fezboy/ece129_discharger/hardware/ece129_discharger.pdf

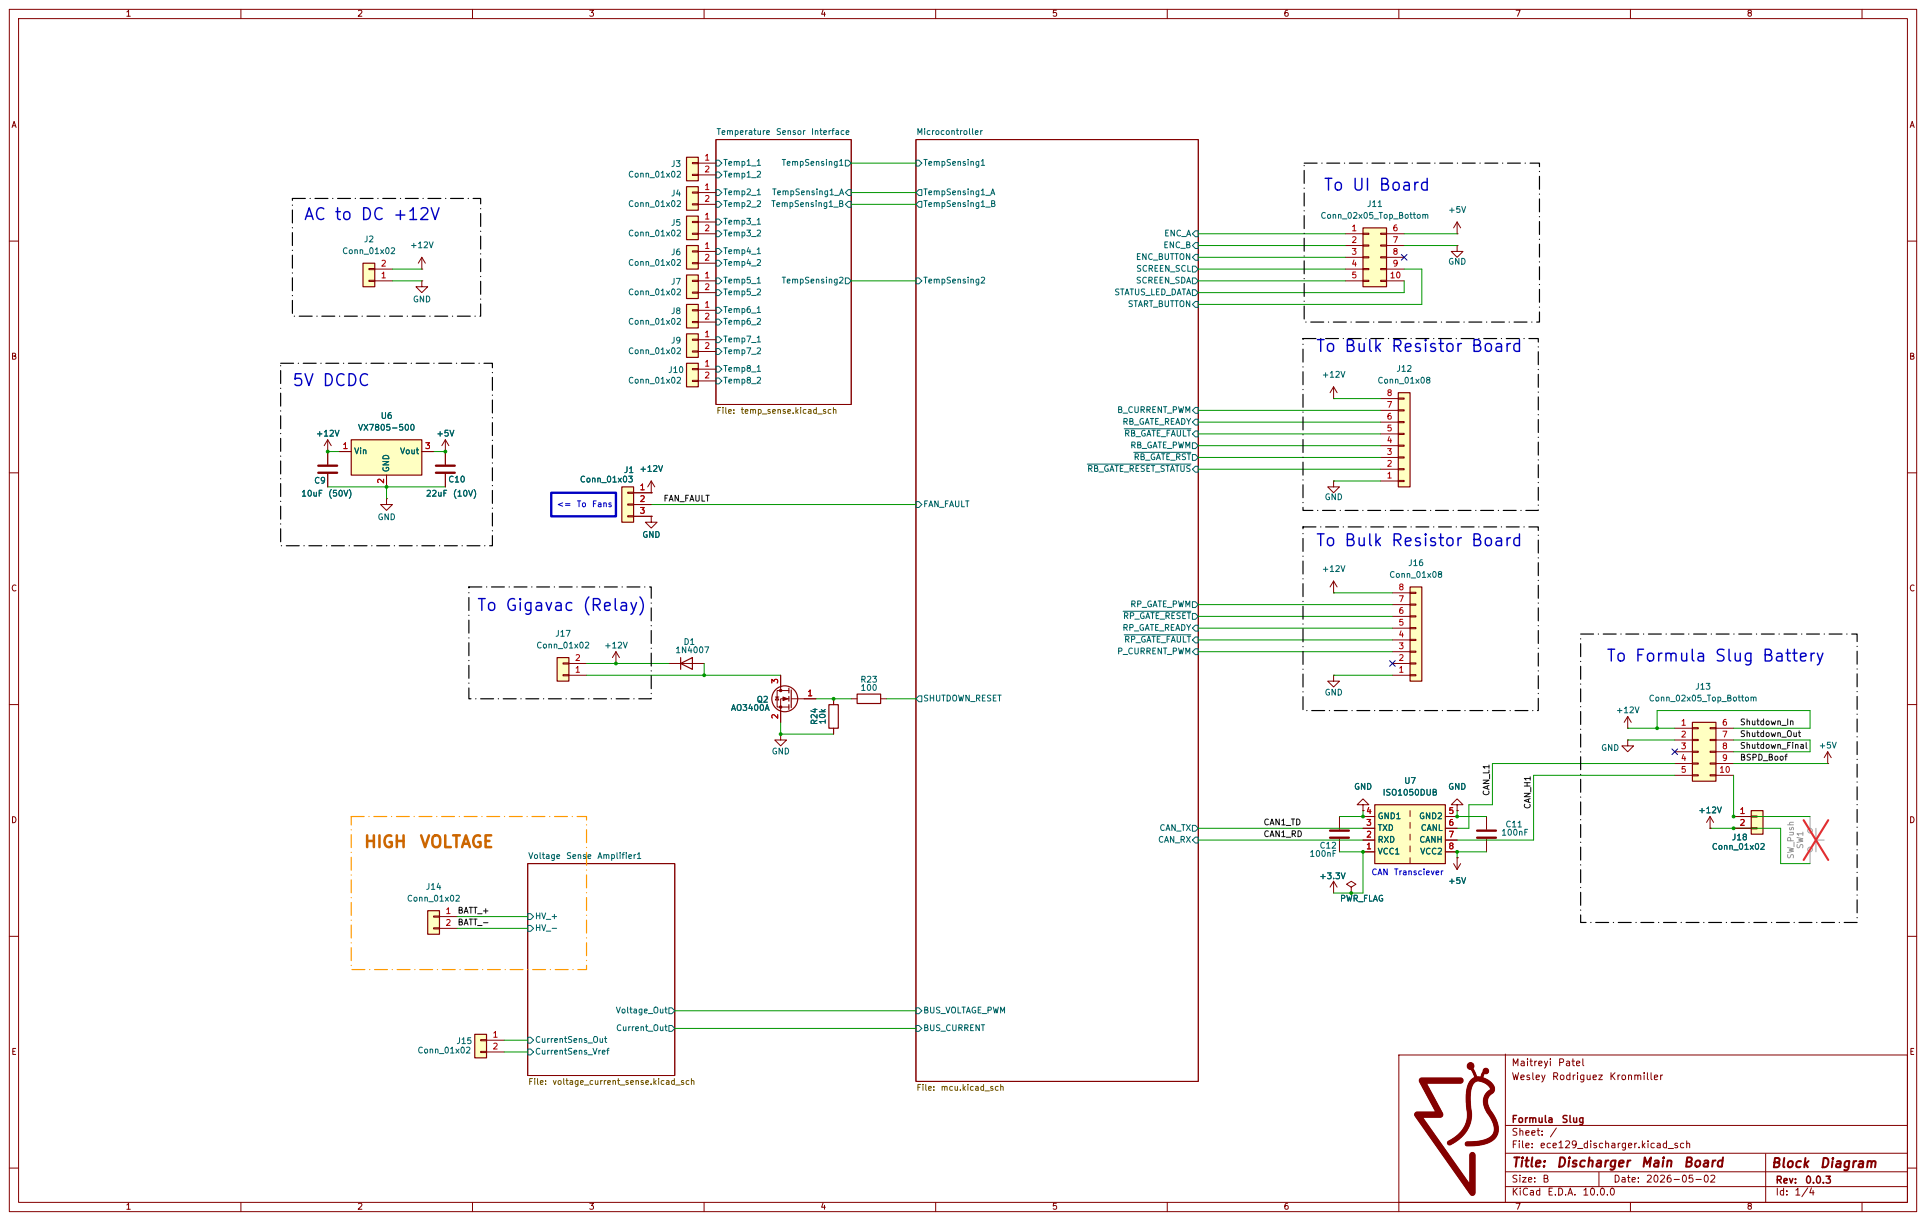
[picture p1: page 1]

To Bulk Resistor Board

CAN_RX CAN_TX P_CURRENT_PWM

6 | J16 Conn_01x08 GND

2 1

To Formula Slug Battery

Title: Discharger Main Board
Size: B | Rev: 0.0.3

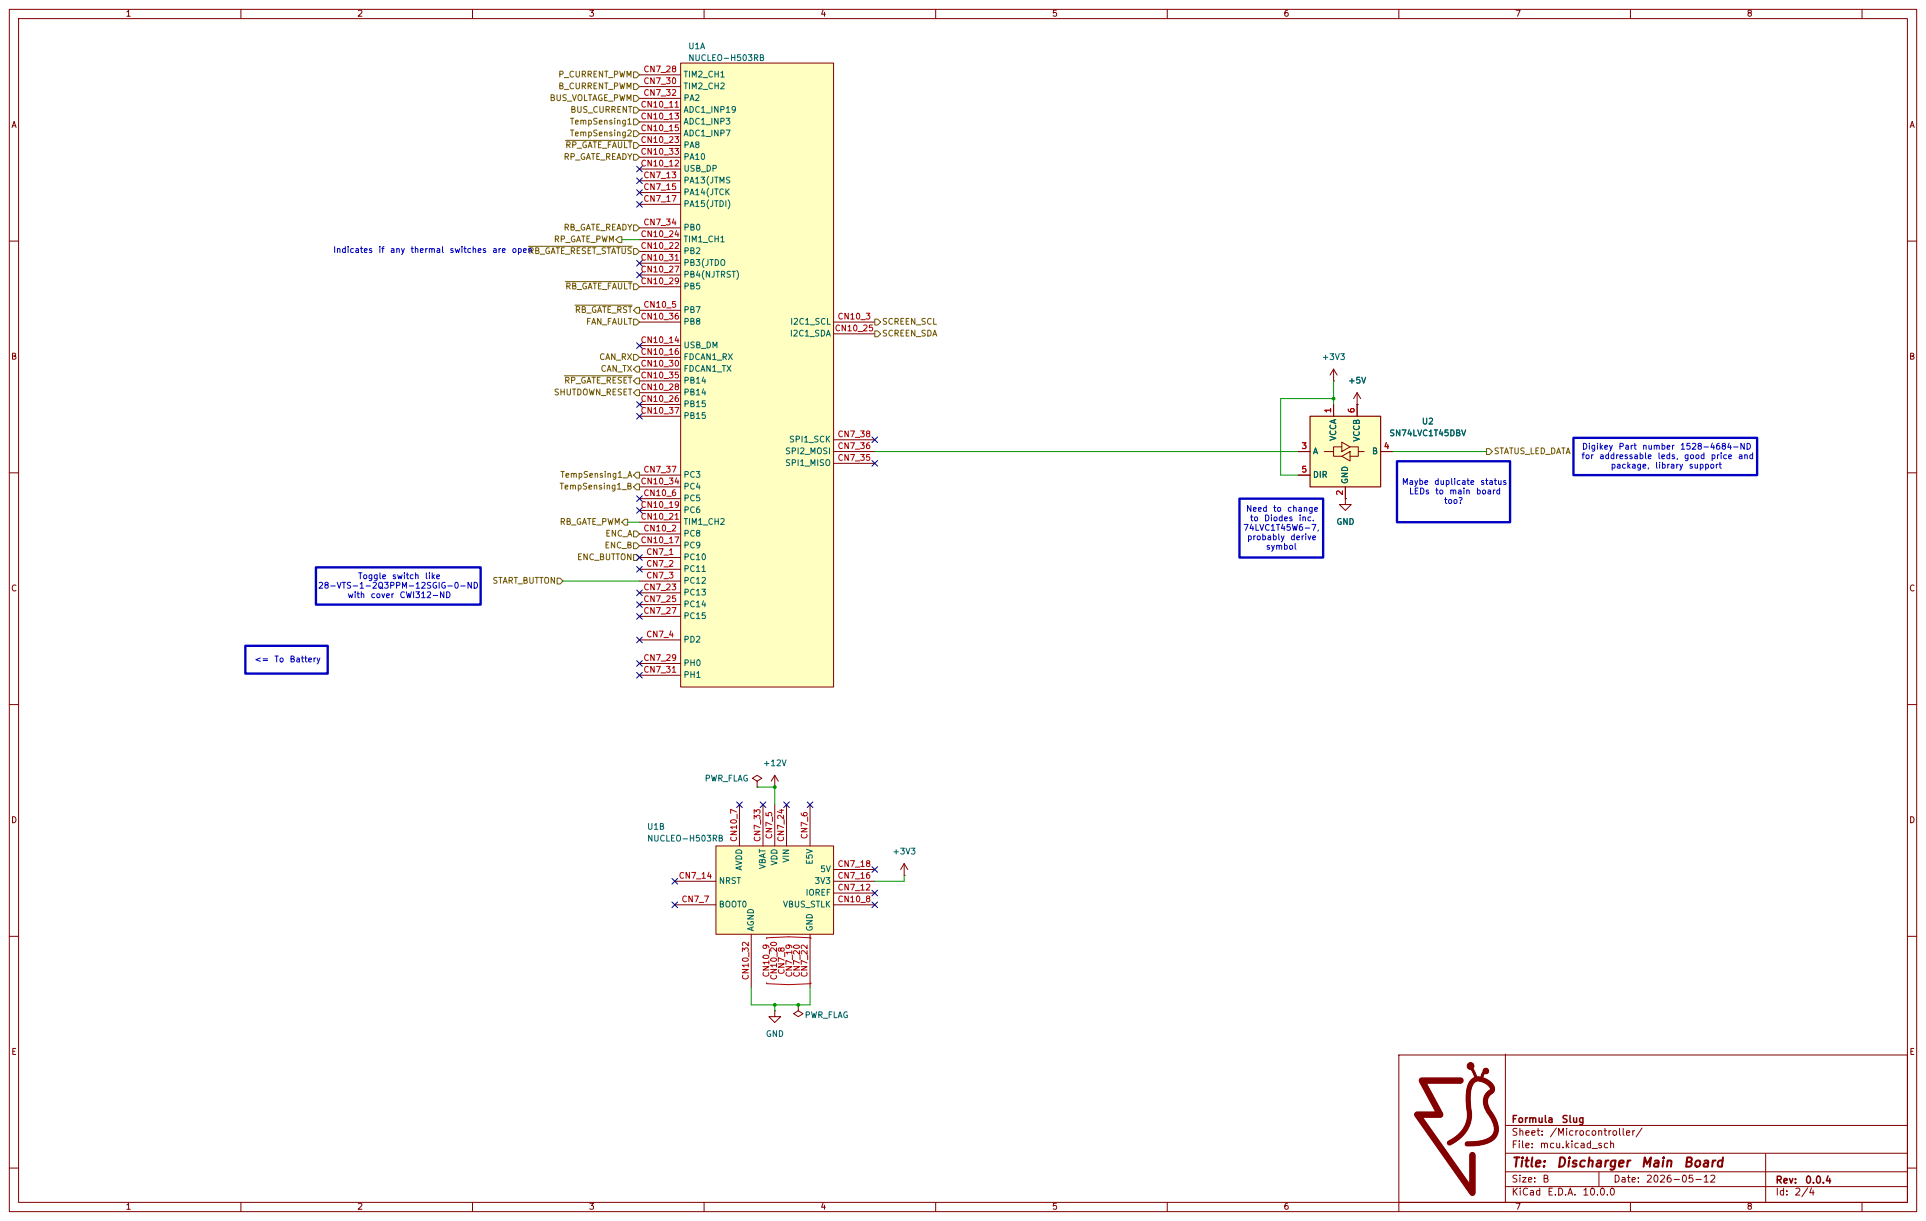
[picture p2: page 2]

for addressable leds, good price and

Maybe duplicate status
LEDs to main board

too? Need to change

to Diodes inc. 74LVC1T45W6-7, probably derive

Toggle switch like 28-VTS-1-2Q3PPM-12SGIG-0-ND with cover CWI312-ND <= To Battery

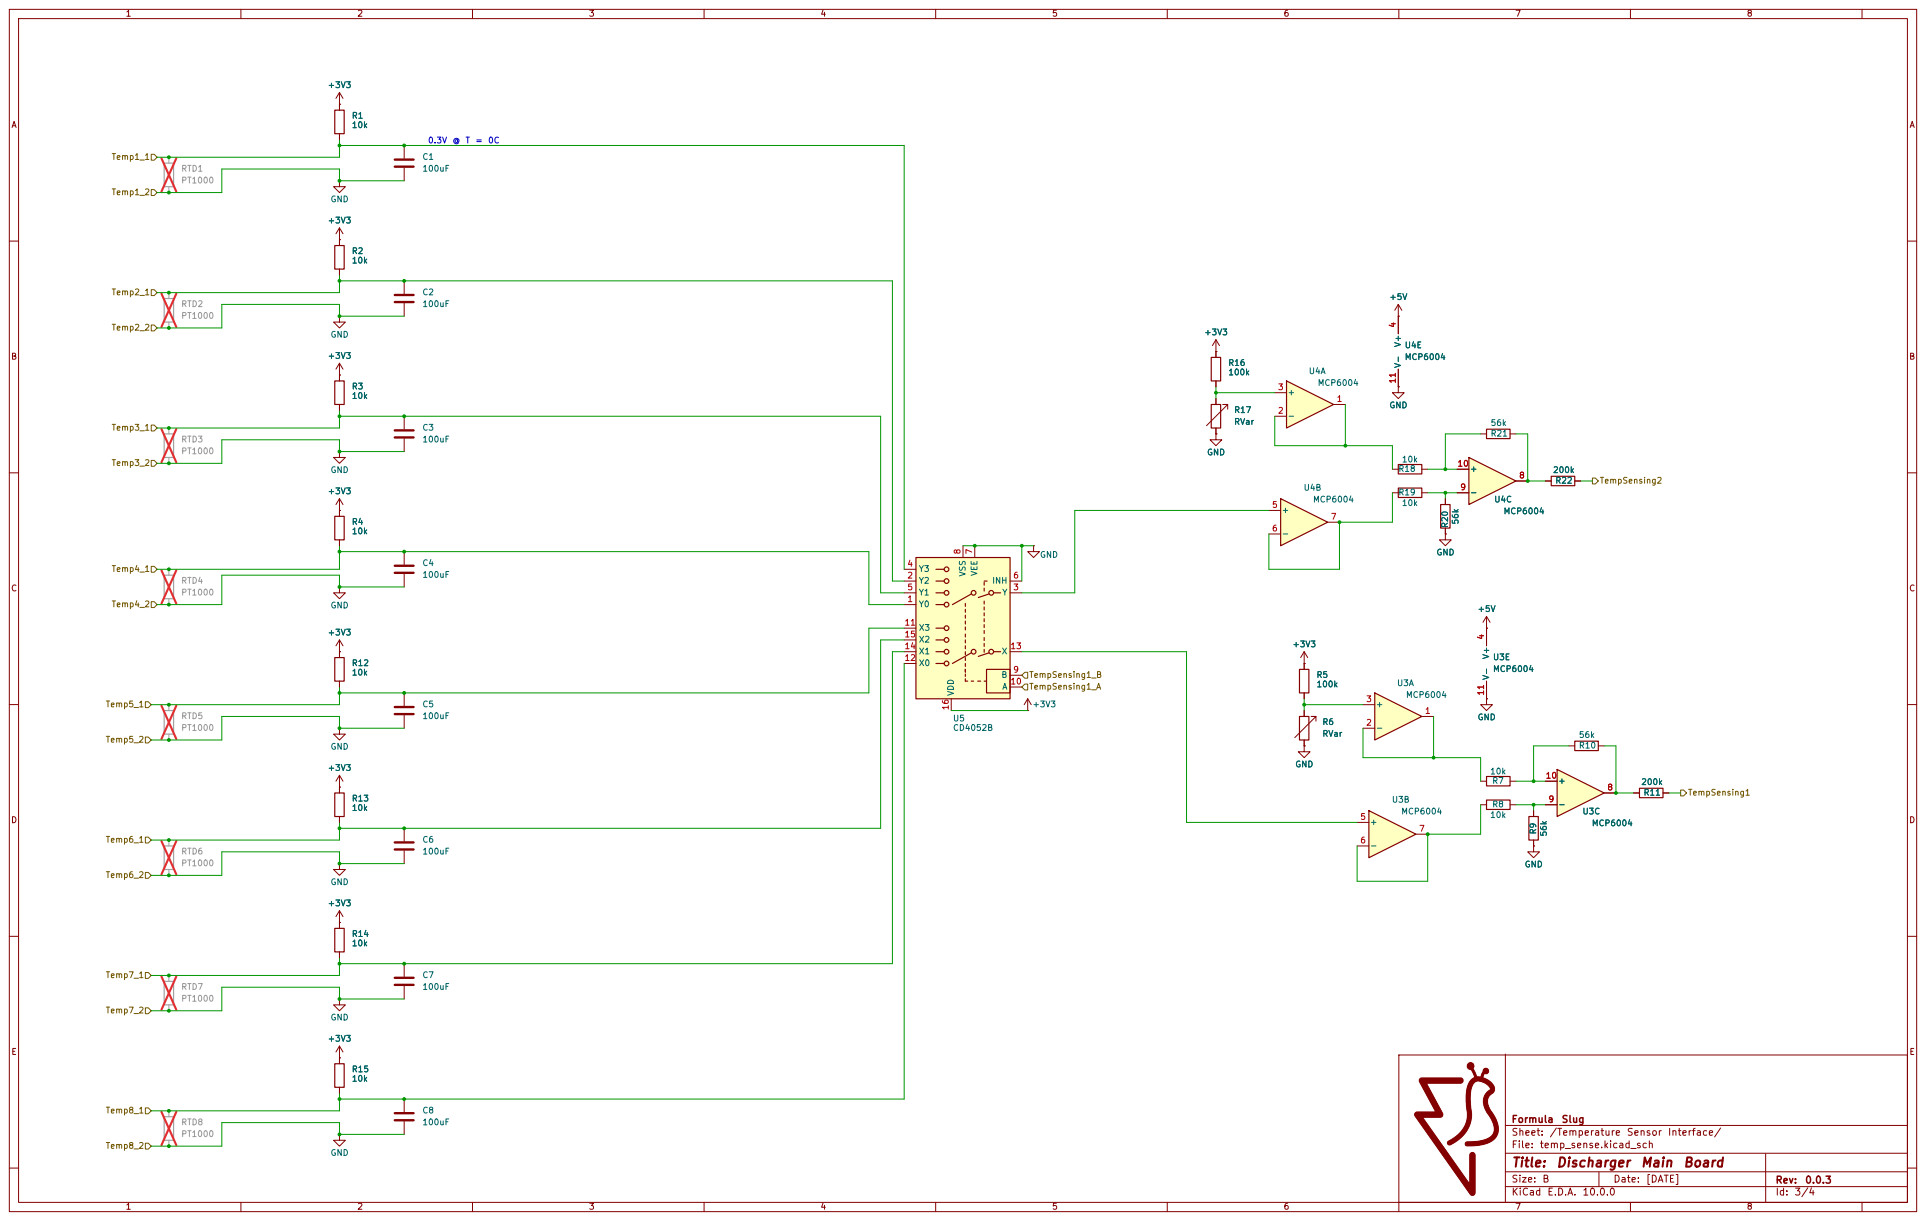
[picture p3: page 3]

Formula Slug
Sheet: /Temperature Sensor Interface/
File: temp_sense.kicad_sch

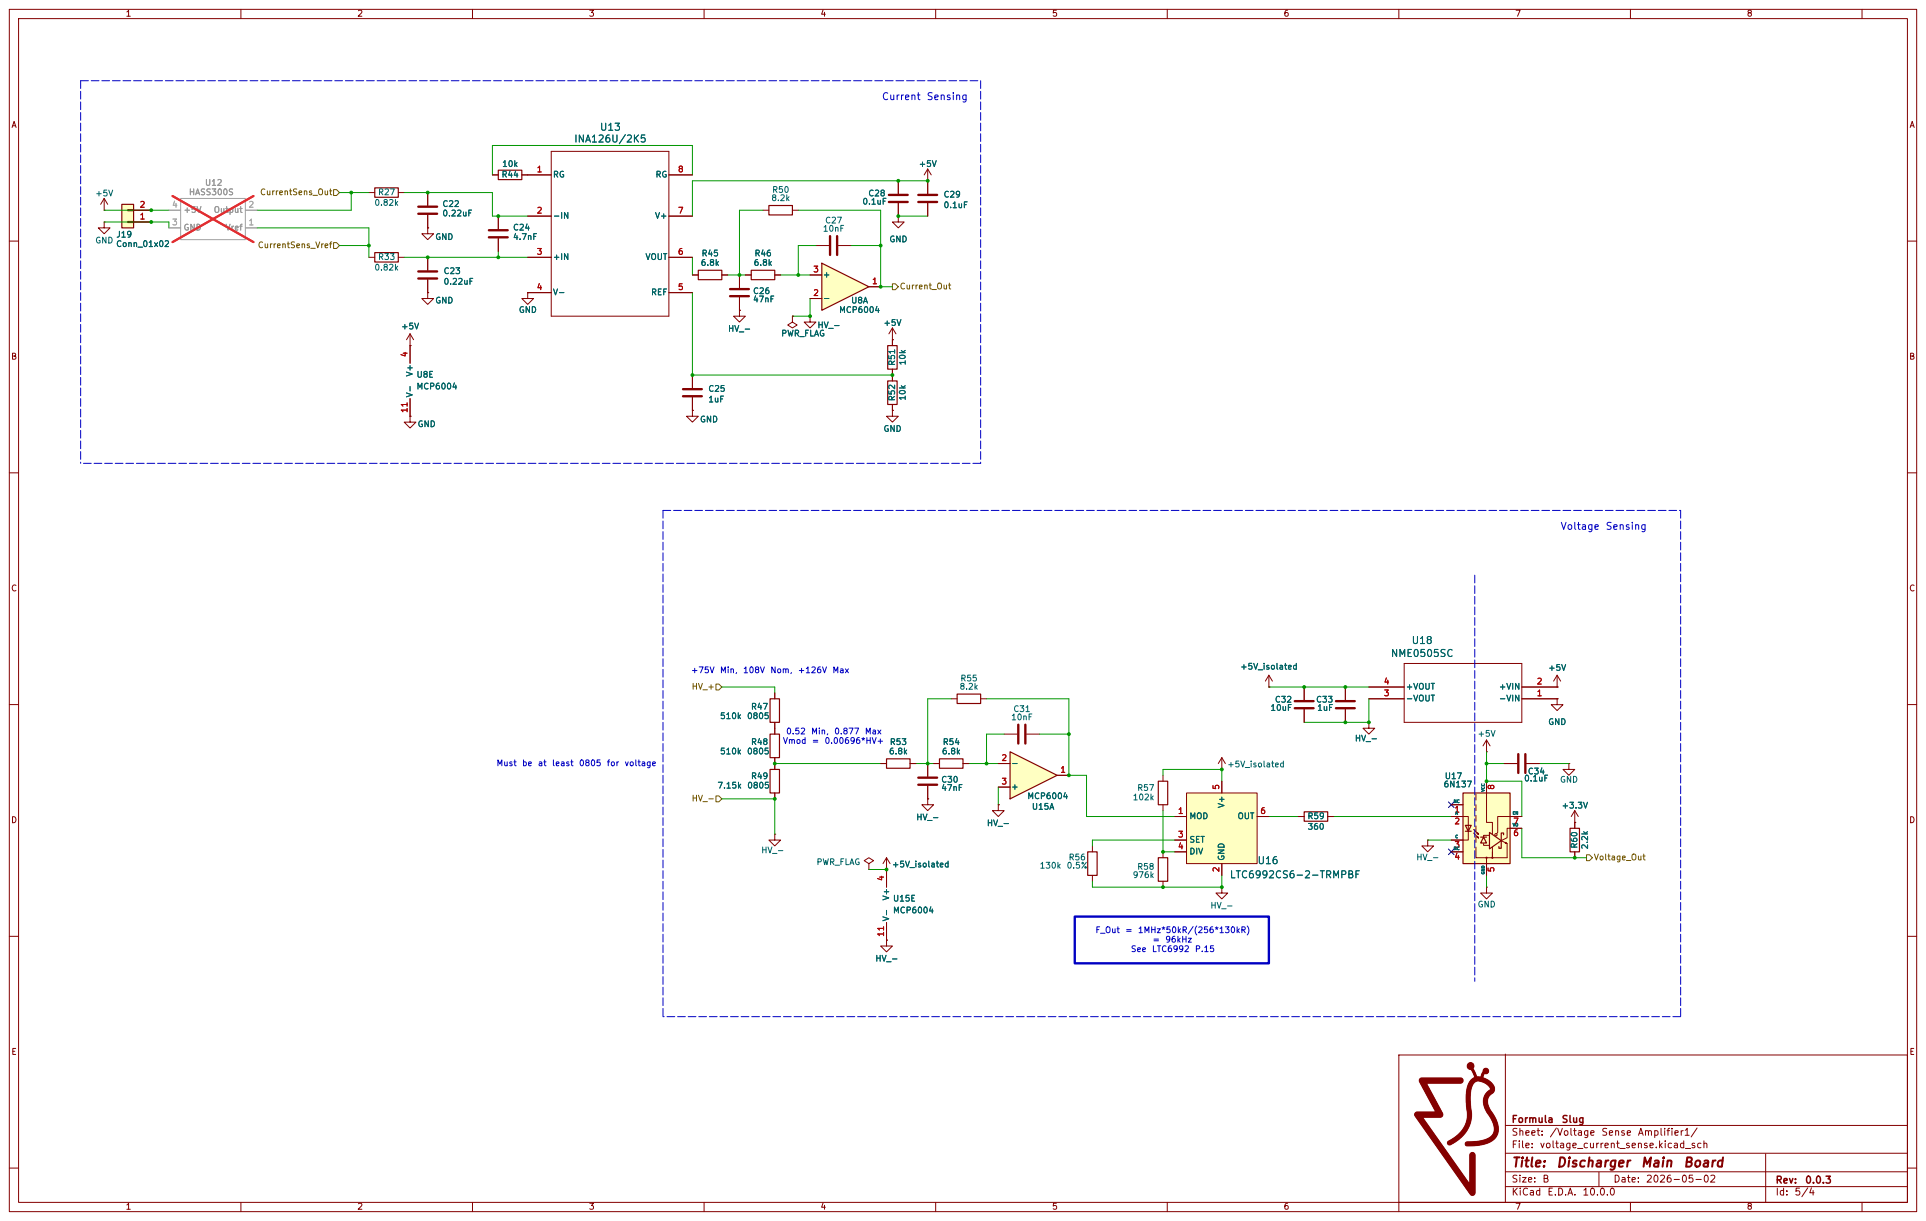
[picture p4: page 4]

5 OUT 6 +5V_isolated U18 NME0505SC -VIN 1 +VIN 2 -VOUT 3 +VOUT 4

0.52 Min, 0.877 Max Vmod = 0.00696*HV+

Must be at least 0805 for voltage
