fezboy/ece129_discharger/hardware/ece129_discharger.kicad_pcb

## KiCad design hardware/ece129_discharger.kicad_pcb (2026-05-23)

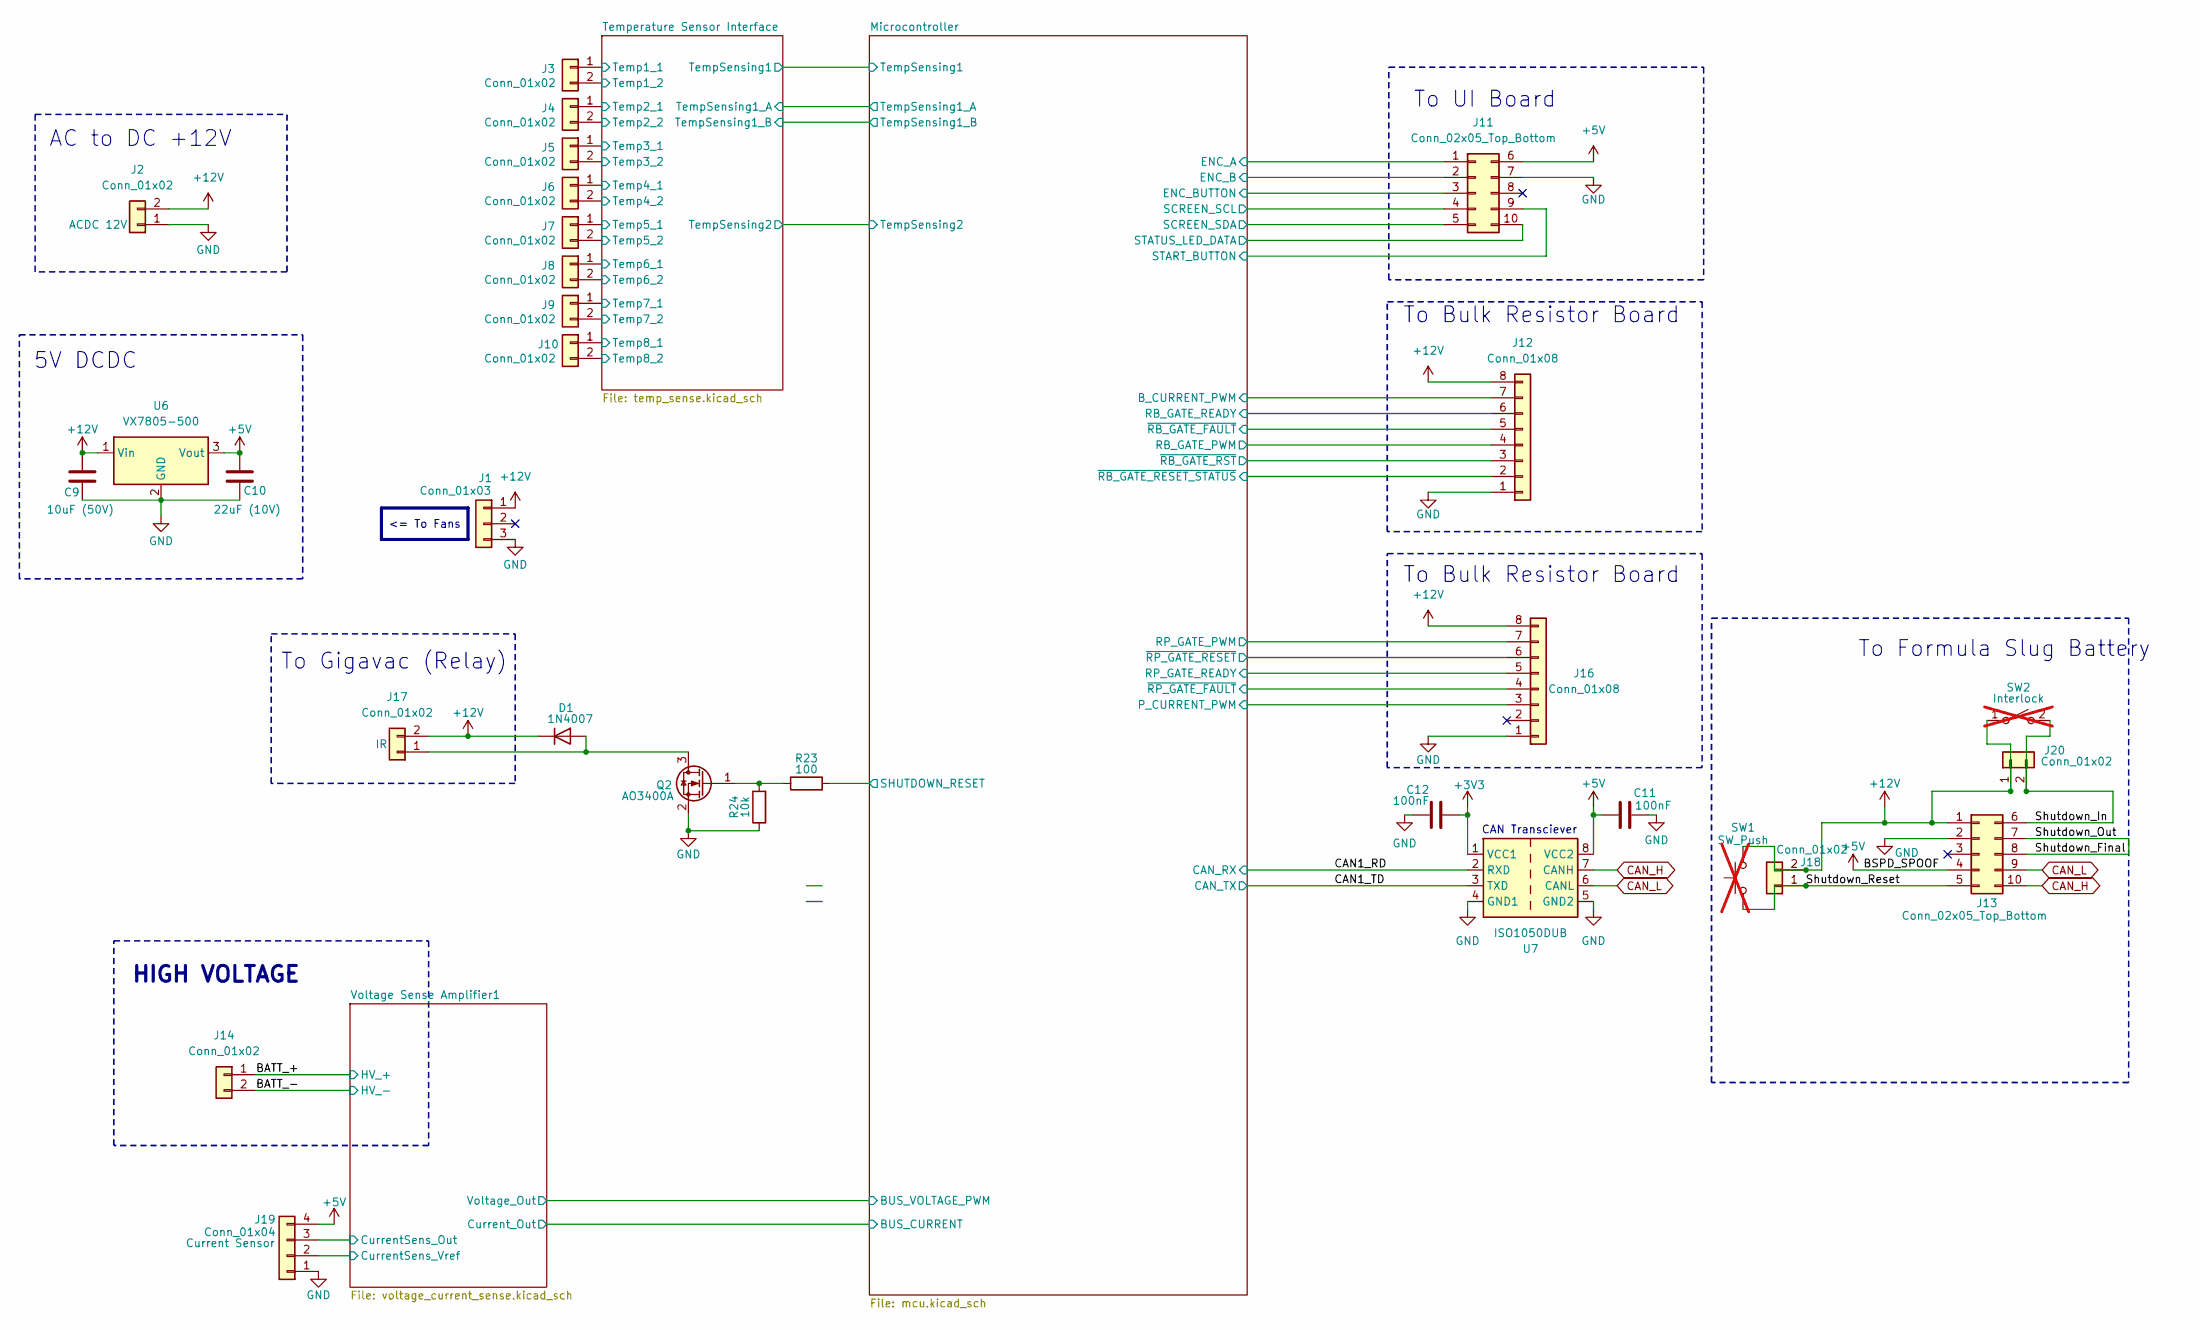
[picture p5: schematic ece129_discharger.kicad_sch, Discharger Main Board]

Parts:
C9: 10uF (50V); C_0805_2012Metric_Pad1.18x1.45mm_HandSolder
C10: 22uF (10V); C_0805_2012Metric_Pad1.18x1.45mm_HandSolder
C11, C12: 100nF; C_0805_2012Metric_Pad1.18x1.45mm_HandSolder
D1: 1N4007; D_DO-41_SOD81_P10.16mm_Horizontal
J1: Conn_01x03; Molex_Nano-Fit_105309-xx03_1x03_P2.50mm_Vertical
J2, J3, J4, J5, J6, J7, J8, J9, J10, J14, J17, J18, J20: Conn_01x02; Molex_Nano-Fit_105309-xx02_1x02_P2.50mm_Vertical
J11, J13: Conn_02x05_Top_Bottom; Molex_Nano-Fit_105310-xx10_2x05_P2.50mm_Vertical
J12, J16: Conn_01x08; Molex_Nano-Fit_105309-xx08_1x08_P2.50mm_Vertical
J19: Conn_01x04; Molex_Nano-Fit_105309-xx04_1x04_P2.50mm_Vertical
Q2: AO3400A; SOT-23
R23: 100; R_0805_2012Metric_Pad1.20x1.40mm_HandSolder
R24: 10k; R_0805_2012Metric_Pad1.20x1.40mm_HandSolder
SW1: SW_Push; not fitted
SW2: Interlock; not fitted
U6: VX7805-500; Converter_DCDC_TRACO_TSR0.5-24xx_TSR0.5-24xxx_THT
U7: ISO1050DUB; SOP-8_6.62x9.15mm_P2.54mm

Connections:
+3V3: C12.2, U7.1 (VCC1); also elsewhere on the board
+5V: C10.1, C11.2, J11.6, J13.4, J19.4, U6.3 (Vout), U7.8 (VCC2); also elsewhere on the board
+12V: C9.1, D1.1 (K), J1.1, J2.2, J12.8, J13.1, J16.8, J17.2, J18.2, J20.1, SW1.1, SW2.1 (A), U6.1 (Vin); also elsewhere on the board
/BATT_+: J14.1; also elsewhere on the board
/CAN1_RD: U7.2 (RXD); also elsewhere on the board
/CAN1_TD: U7.3 (TXD); also elsewhere on the board
/Microcontroller/B_CURRENT_PWM: J12.7; also elsewhere on the board
/Microcontroller/ENC_A: J11.1; also elsewhere on the board
/Microcontroller/ENC_B: J11.2; also elsewhere on the board
/Microcontroller/ENC_BUTTON: J11.3; also elsewhere on the board
/Microcontroller/P_CURRENT_PWM: J16.3; also elsewhere on the board
/Microcontroller/RB_GATE_PWM: J12.4; also elsewhere on the board
/Microcontroller/RB_GATE_READY: J12.6; also elsewhere on the board
/Microcontroller/RP_GATE_PWM: J16.7; also elsewhere on the board
/Microcontroller/RP_GATE_READY: J16.5; also elsewhere on the board
/Microcontroller/SCREEN_SCL: J11.4; also elsewhere on the board
/Microcontroller/SCREEN_SDA: J11.5; also elsewhere on the board
/Microcontroller/SHUTDOWN_RESET: R23.2; also elsewhere on the board
/Microcontroller/START_BUTTON: J11.9; also elsewhere on the board
/Microcontroller/STATUS_LED_DATA: J11.10; also elsewhere on the board
/Microcontroller/~RB_GATE_FAULT: J12.5; also elsewhere on the board
/Microcontroller/~RB_GATE_RESET_STATUS: J12.2; also elsewhere on the board
/Microcontroller/~RB_GATE_RST: J12.3; also elsewhere on the board
/Microcontroller/~RP_GATE_FAULT: J16.4; also elsewhere on the board
/Microcontroller/~RP_GATE_RESET: J16.6; also elsewhere on the board
/Shutdown_Final: J13.7, J13.8
/Shutdown_In: J13.6, J20.2, SW2.2 (B)
/Shutdown_Reset: J13.5, J18.1, SW1.2
/Temperature Sensor Interface/Temp1_1: J3.1; also elsewhere on the board
/Temperature Sensor Interface/Temp2_1: J4.1; also elsewhere on the board
/Temperature Sensor Interface/Temp3_1: J5.1; also elsewhere on the board
/Temperature Sensor Interface/Temp4_1: J6.1; also elsewhere on the board
/Temperature Sensor Interface/Temp5_1: J7.1; also elsewhere on the board
/Temperature Sensor Interface/Temp6_1: J8.1; also elsewhere on the board
/Temperature Sensor Interface/Temp7_1: J9.1; also elsewhere on the board
/Temperature Sensor Interface/Temp8_1: J10.1; also elsewhere on the board
/Voltage Sense Amplifier1/CurrentSens_Out: J19.3; also elsewhere on the board
/Voltage Sense Amplifier1/CurrentSens_Vref: J19.2; also elsewhere on the board
CAN_H: J13.10, U7.7 (CANH)
CAN_L: J13.9, U7.6 (CANL)
GND: C9.2, C10.2, C11.1, C12.1, J1.3, J2.1, J3.2, J4.2, J5.2, J6.2, J7.2, J8.2, J9.2, J10.2, J11.7, J12.1, J13.2, J16.1, J19.1, Q2.2 (S), R24.1, U6.2 (GND), U7.4 (GND1), U7.5 (GND2); also elsewhere on the board
HV_-: J14.2; also elsewhere on the board
unnamed: D1.2 (A), J17.1, Q2.3 (D)
unnamed: Q2.1 (G), R23.1, R24.2

Notes on the sheet:
CAN Transciever
AC to DC +12V
5V DCDC
To Bulk Resistor Board
HIGH VOLTAGE
To UI Board
To Formula Slug Battery
To Gigavac (Relay)
<= To Fans

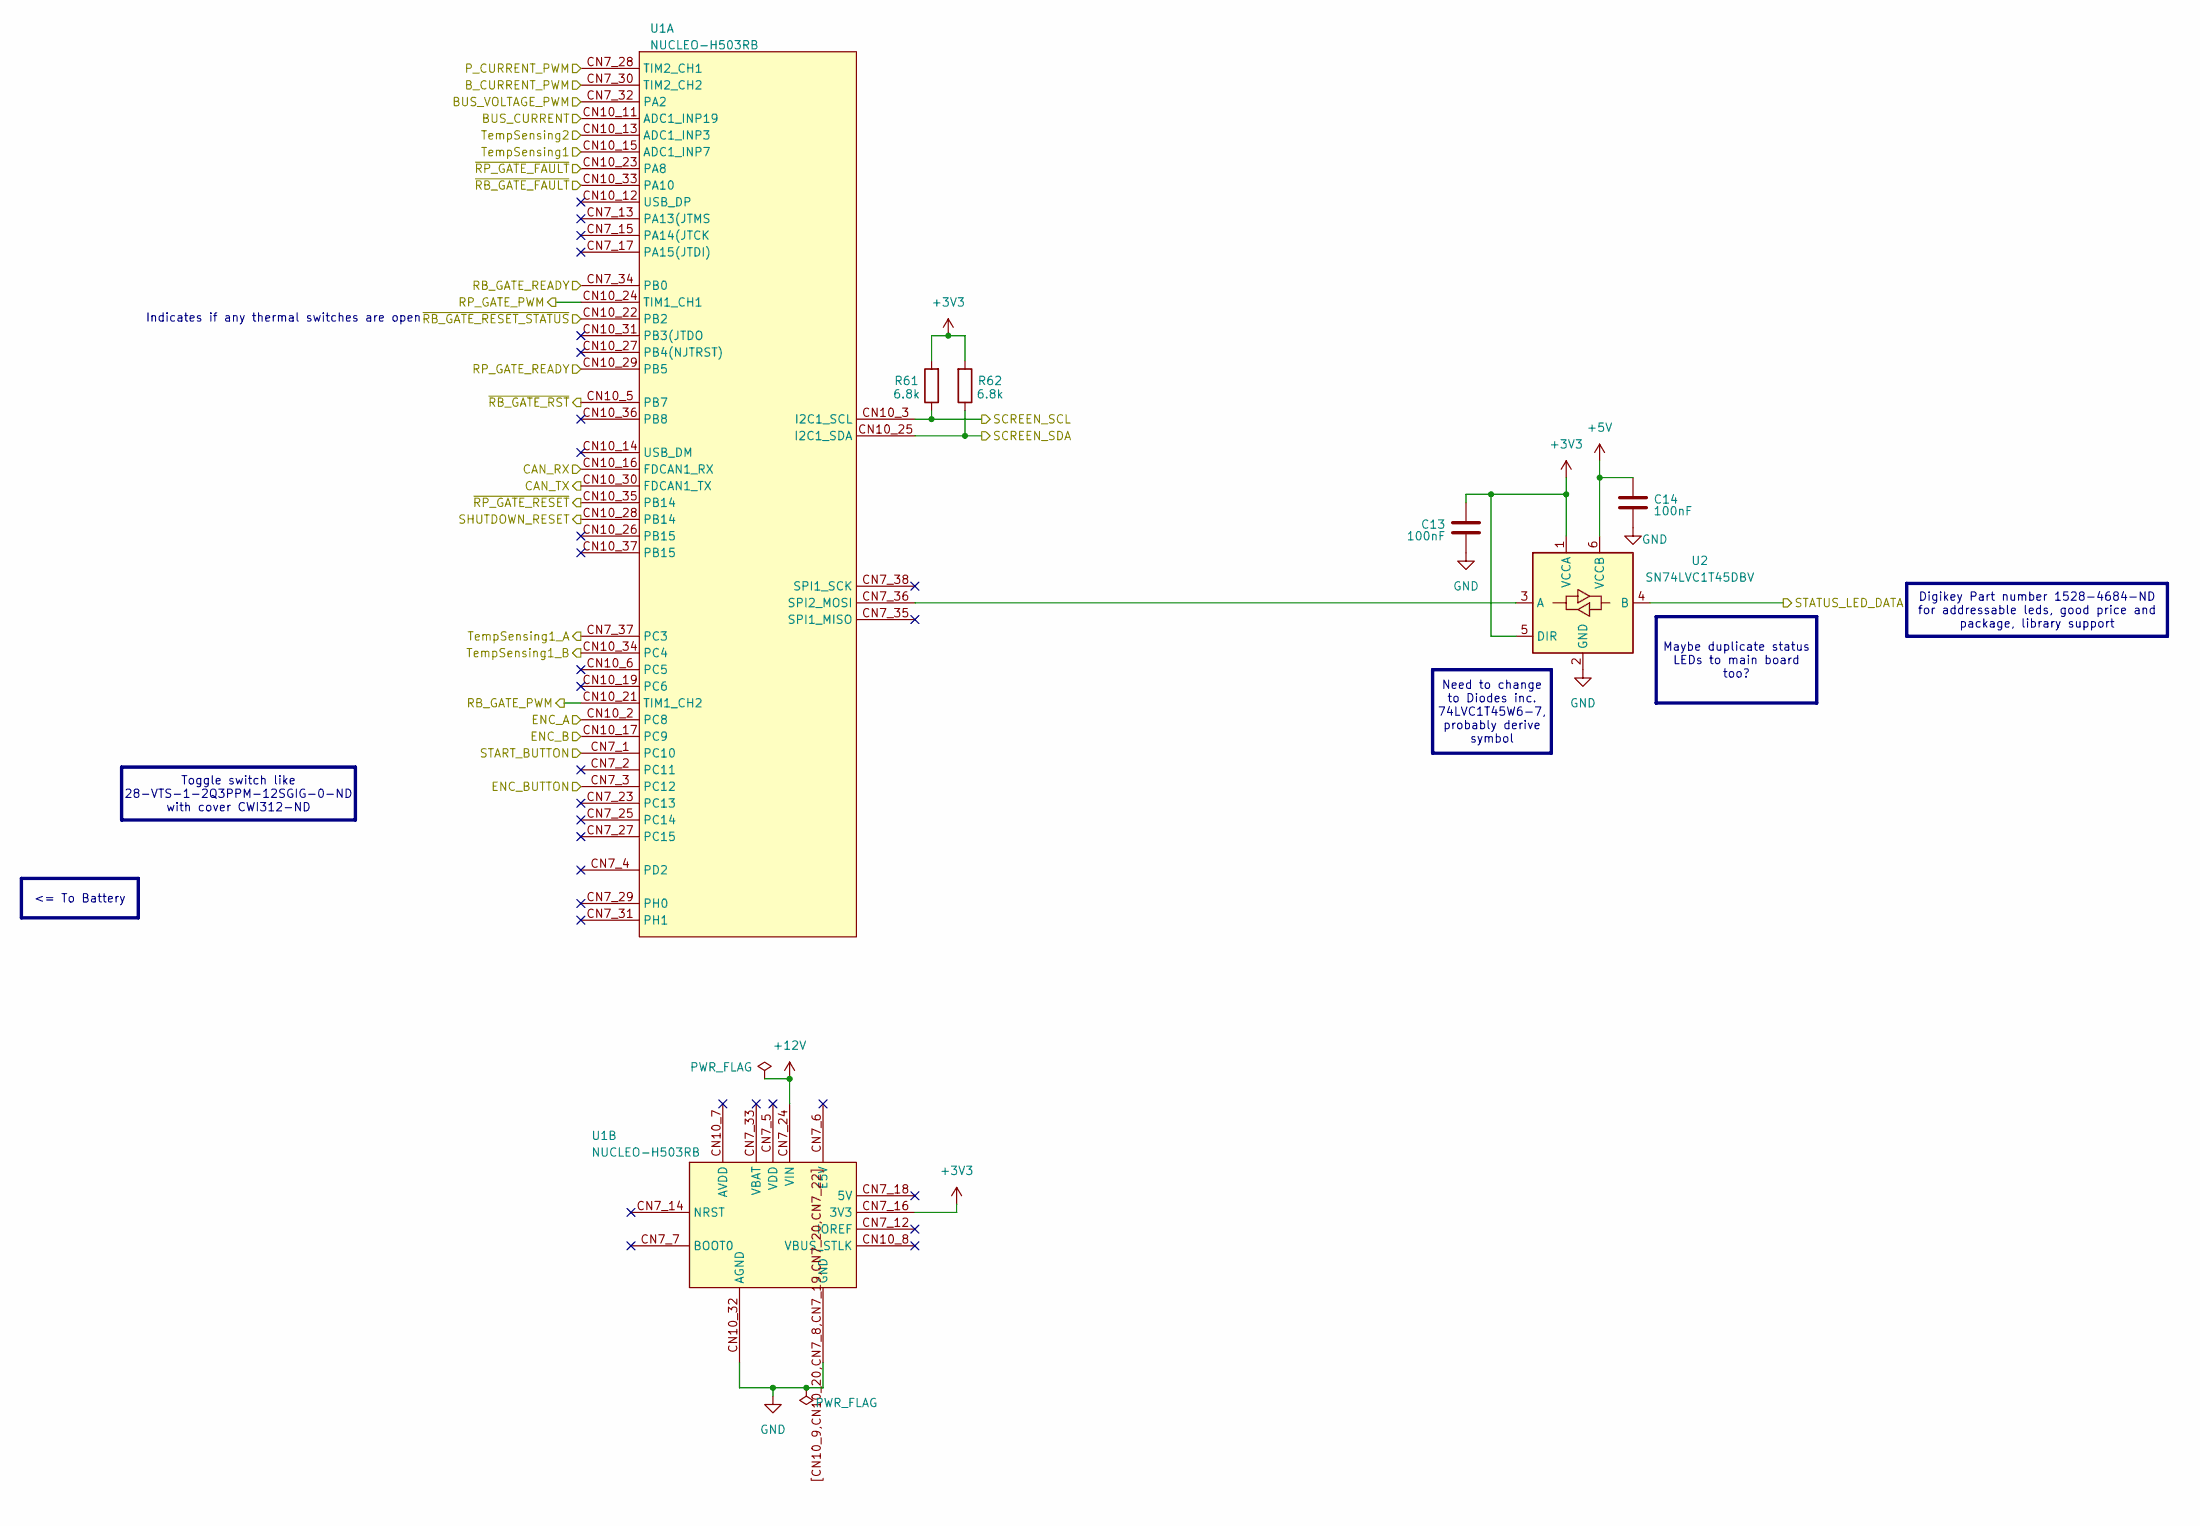
[picture p6: schematic mcu.kicad_sch, Discharger Main Board]

Parts:
C13, C14: 100nF; C_0805_2012Metric_Pad1.18x1.45mm_HandSolder
R61, R62: 6.8k; R_0805_2012Metric_Pad1.20x1.40mm_HandSolder
U1: NUCLEO-H503RB
U2: SN74LVC1T45DBV; SOT-23-6

Connections:
+3V3: C13.1, R61.2, R62.2, U1.CN7_16 (3V3), U2.1 (VCCA), U2.5 (DIR); also elsewhere on the board
+5V: C14.1, U2.6 (VCCB); also elsewhere on the board
+12V: U1.CN7_24 (VIN); also elsewhere on the board
/CAN1_RD: U1.CN10_16 (FDCAN1_RX); also elsewhere on the board
/CAN1_TD: U1.CN10_30 (FDCAN1_TX); also elsewhere on the board
/Microcontroller/BUS_CURRENT: U1.CN10_11 (ADC1_INP19); also elsewhere on the board
/Microcontroller/BUS_VOLTAGE_PWM: U1.CN7_32 (PA2); also elsewhere on the board
/Microcontroller/B_CURRENT_PWM: U1.CN7_30 (TIM2_CH2); also elsewhere on the board
/Microcontroller/ENC_A: U1.CN10_2 (PC8); also elsewhere on the board
/Microcontroller/ENC_B: U1.CN10_17 (PC9); also elsewhere on the board
/Microcontroller/ENC_BUTTON: U1.CN7_3 (PC12); also elsewhere on the board
/Microcontroller/P_CURRENT_PWM: U1.CN7_28 (TIM2_CH1); also elsewhere on the board
/Microcontroller/RB_GATE_PWM: U1.CN10_21 (TIM1_CH2); also elsewhere on the board
/Microcontroller/RB_GATE_READY: U1.CN7_34 (PB0); also elsewhere on the board
/Microcontroller/RP_GATE_PWM: U1.CN10_24 (TIM1_CH1); also elsewhere on the board
/Microcontroller/RP_GATE_READY: U1.CN10_29 (PB5); also elsewhere on the board
/Microcontroller/SCREEN_SCL: R61.1, U1.CN10_3 (I2C1_SCL); also elsewhere on the board
/Microcontroller/SCREEN_SDA: R62.1, U1.CN10_25 (I2C1_SDA); also elsewhere on the board
/Microcontroller/SHUTDOWN_RESET: U1.CN10_28 (PB14); also elsewhere on the board
/Microcontroller/START_BUTTON: U1.CN7_1 (PC10); also elsewhere on the board
/Microcontroller/STATUS_LED_DATA: U2.4 (B); also elsewhere on the board
/Microcontroller/TempSensing1: U1.CN10_15 (ADC1_INP7); also elsewhere on the board
/Microcontroller/TempSensing1_A: U1.CN7_37 (PC3); also elsewhere on the board
/Microcontroller/TempSensing1_B: U1.CN10_34 (PC4); also elsewhere on the board
/Microcontroller/TempSensing2: U1.CN10_13 (ADC1_INP3); also elsewhere on the board
/Microcontroller/~RB_GATE_FAULT: U1.CN10_33 (PA10); also elsewhere on the board
/Microcontroller/~RB_GATE_RESET_STATUS: U1.CN10_22 (PB2); also elsewhere on the board
/Microcontroller/~RB_GATE_RST: U1.CN10_5 (PB7); also elsewhere on the board
/Microcontroller/~RP_GATE_FAULT: U1.CN10_23 (PA8); also elsewhere on the board
/Microcontroller/~RP_GATE_RESET: U1.CN10_35 (PB14); also elsewhere on the board
GND: C13.2, C14.2, U1.CN7_8 (GND), U1.CN7_19 (GND), U1.CN7_20 (GND), U1.CN7_22 (GND), U1.CN10_9 (GND), U1.CN10_20 (GND), U1.CN10_32 (AGND), U1.[CN10_9,CN10_20,CN7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 (GND), U2.2 (GND); also elsewhere on the board
unnamed: U1.CN7_36 (SPI2_MOSI), U2.3 (A)

Notes on the sheet:
Indicates if any thermal switches are open
Digikey Part number 1528-4684-ND for addressable leds, good price and package, library support
Toggle switch like 28-VTS-1-2Q3PPM-12SGIG-0-ND with cover CWI312-ND
Need to change to Diodes inc. 74LVC1T45W6-7, probably derive symbol
Maybe duplicate status LEDs to main board too?
<= To Battery

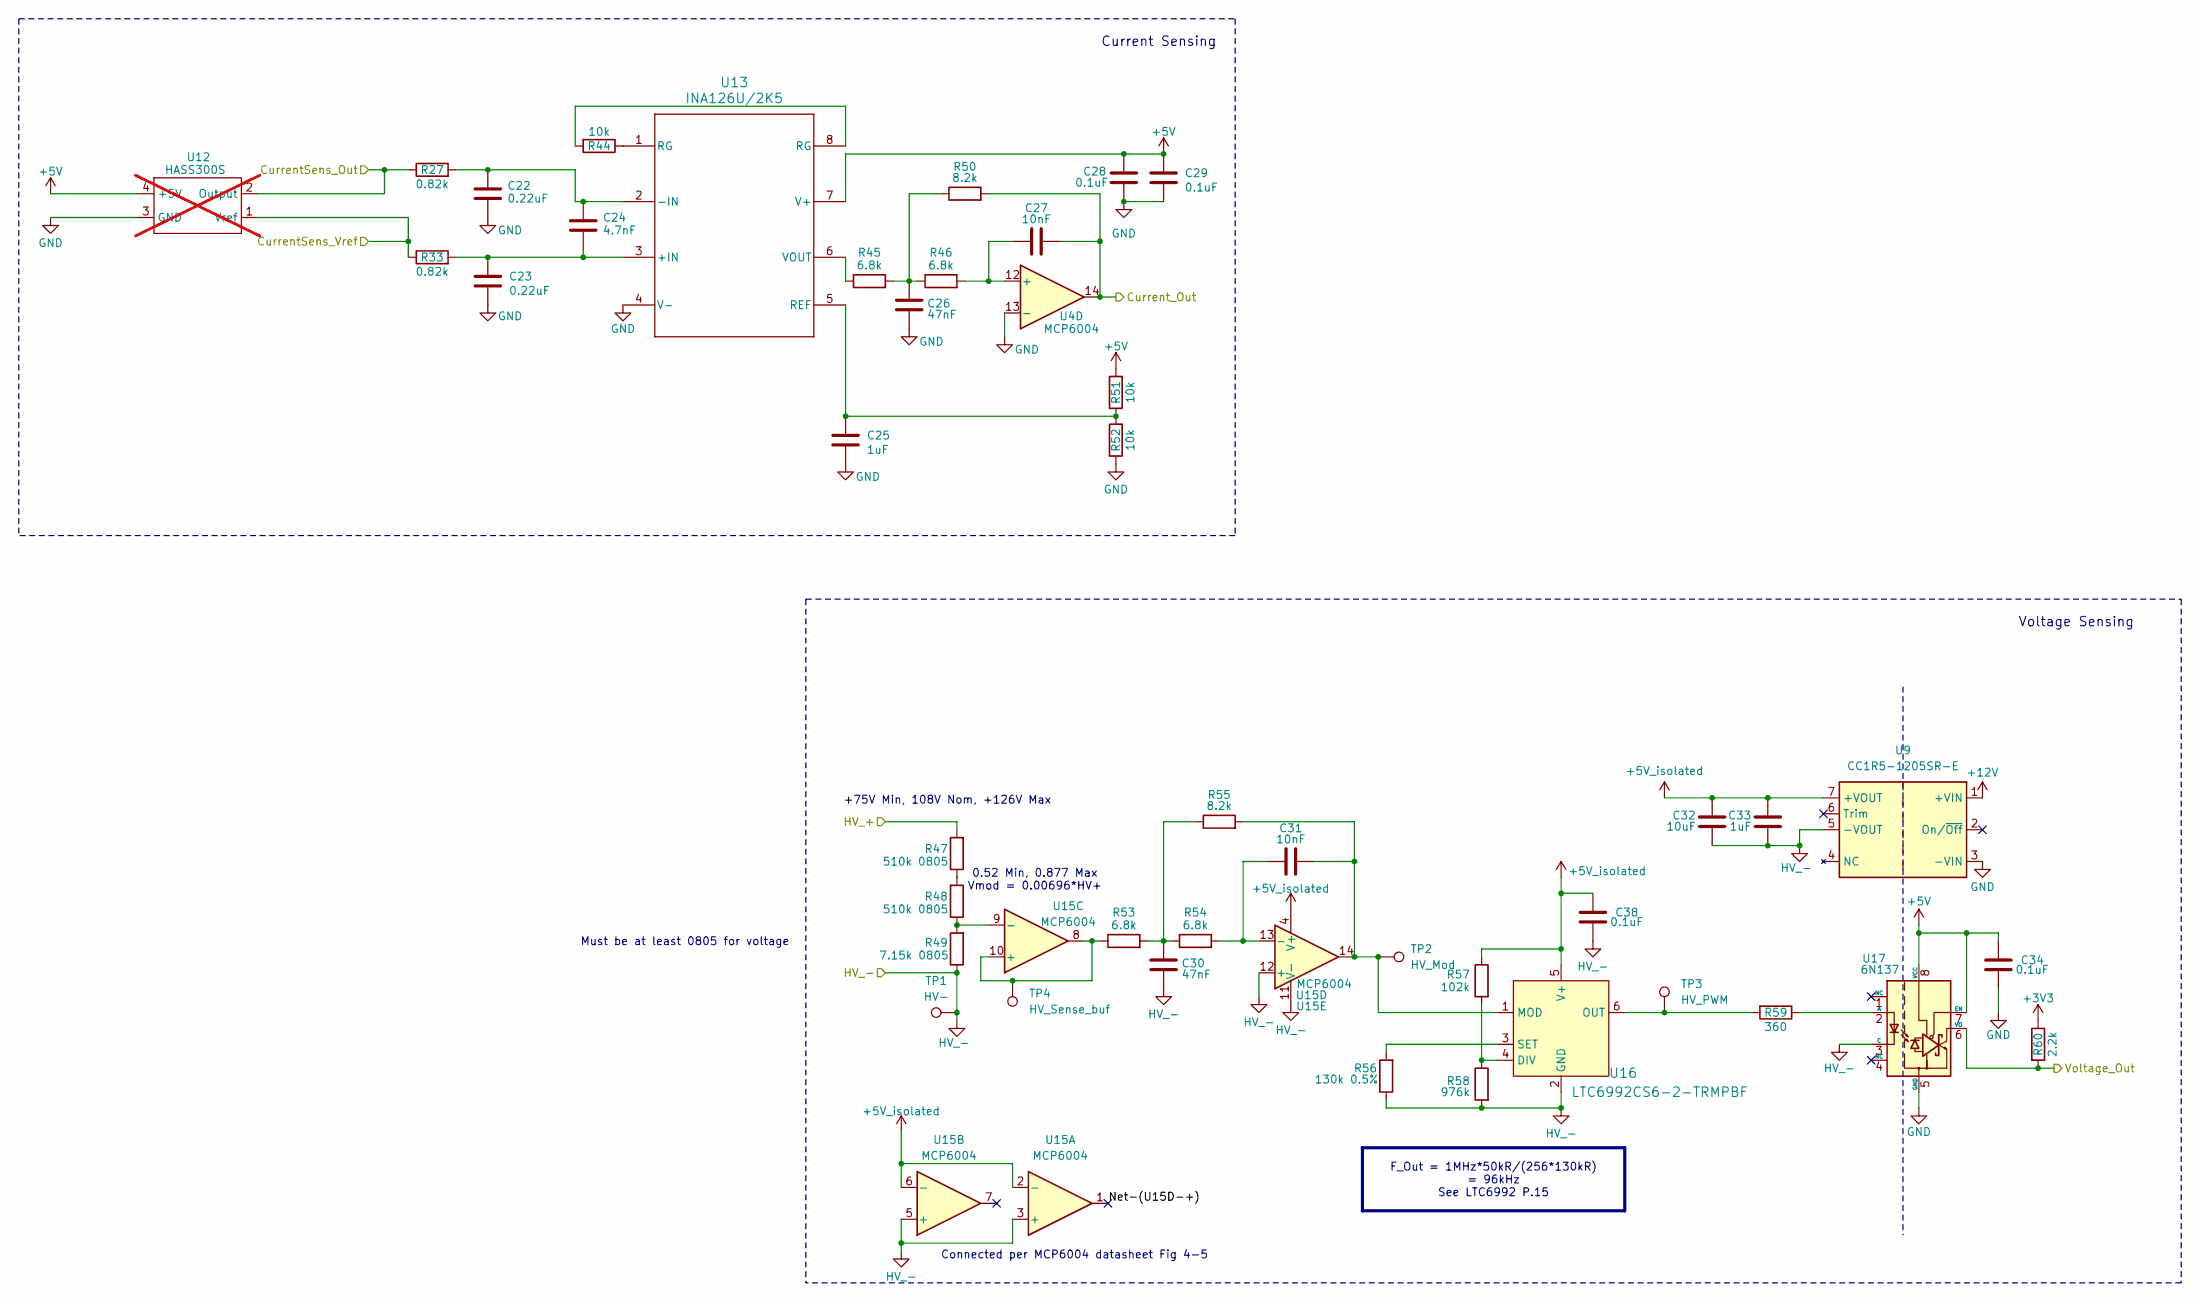
[picture p7: schematic voltage_current_sense.kicad_sch, Discharger Main Board]

Parts:
C22, C23: 0.22uF; C_0805_2012Metric_Pad1.18x1.45mm_HandSolder
C24: 4.7nF; C_0805_2012Metric_Pad1.18x1.45mm_HandSolder
C25, C33: 1uF; C_0805_2012Metric_Pad1.18x1.45mm_HandSolder
C26, C30: 47nF; C_0805_2012Metric_Pad1.18x1.45mm_HandSolder
C27, C31: 10nF; C_0805_2012Metric_Pad1.18x1.45mm_HandSolder
C28, C29, C34, C38: 0.1uF; C_0805_2012Metric_Pad1.18x1.45mm_HandSolder
C32: 10uF; C_0805_2012Metric_Pad1.18x1.45mm_HandSolder
R27, R33: 0.82k; R_0805_2012Metric_Pad1.20x1.40mm_HandSolder
R44, R51, R52: 10k; R_0805_2012Metric_Pad1.20x1.40mm_HandSolder
R45, R46, R53, R54: 6.8k; R_0805_2012Metric_Pad1.20x1.40mm_HandSolder
R47, R48: 510k 0805; R_0805_2012Metric_Pad1.20x1.40mm_HandSolder
R49: 7.15k 0805; R_0805_2012Metric_Pad1.20x1.40mm_HandSolder
R50, R55: 8.2k; R_0805_2012Metric_Pad1.20x1.40mm_HandSolder
R56: 130k 0.5%; R_0805_2012Metric_Pad1.20x1.40mm_HandSolder
R57: 102k; R_0805_2012Metric_Pad1.20x1.40mm_HandSolder
R58: 976k; R_0805_2012Metric_Pad1.20x1.40mm_HandSolder
R59: 360; R_0805_2012Metric_Pad1.20x1.40mm_HandSolder
R60: 2.2k; R_0805_2012Metric_Pad1.20x1.40mm_HandSolder
TP1: HV-; TestPoint_Keystone_5015_Micro_Mini
TP2: HV_Mod; TestPoint_Keystone_5015_Micro_Mini
TP3: HV_PWM; TestPoint_Keystone_5015_Micro_Mini
TP4: HV_Sense_buf; TestPoint_Keystone_5015_Micro_Mini
U4, U15: MCP6004; SOIC-14_3.9x8.7mm_P1.27mm
U9: CC1R5-1205SR-E; MFG PN CC1R5-1205SR-E; Digi PN 445-2453-ND
U12: HASS300S; not fitted
U13: INA126U/2K5; SOIC-8_5.3x6.2mm_P1.27mm
U16: LTC6992CS6-2-TRMPBF; TSOT-23-6; MFG PN LTC6992CS6-2-TRMPBF; Digi PN 505-LTC6992CS6-2#TRMPBFCT-ND
U17: 6N137; DIP-8_W7.62mm

Connections:
+3V3: R60.1; also elsewhere on the board
+5V: C28.1, C29.1, C34.1, R51.2, U12.4 (+5V), U13.7 (V+), U17.7 (EN), U17.8 (VCC); also elsewhere on the board
+5V_isolated: C32.1, C33.1, C38.1, R57.1, U9.7 (+VOUT), U15.2 (-), U15.4 (V+), U15.6 (-), U16.5 (V+)
+12V: U9.1 (+VIN); also elsewhere on the board
/BATT_+: R47.2; also elsewhere on the board
/Microcontroller/BUS_CURRENT: C27.2, R50.2, U4.14; also elsewhere on the board
/Microcontroller/BUS_VOLTAGE_PWM: R60.2, U17.6 (VO); also elsewhere on the board
/Voltage Sense Amplifier1/CurrentSens_Out: R27.1, U12.2 (Output); also elsewhere on the board
/Voltage Sense Amplifier1/CurrentSens_Vref: R33.1, U12.1 (Vref); also elsewhere on the board
/Voltage Sense Amplifier1/Net-(U15D-+): U15.1
GND: C22.2, C23.2, C25.2, C26.1, C28.2, C29.2, C34.2, R52.1, U4.13 (-), U9.3 (-VIN), U12.3 (GND), U13.4 (V-), U17.5 (GND); also elsewhere on the board
HV_-: C30.1, C32.2, C33.2, C38.2, R49.1, R56.1, R58.2, TP1.1 (1_1), U9.5 (-VOUT), U15.3 (+), U15.5 (+), U15.11 (V-), U15.12 (+), U16.2 (GND), U17.3 (C); also elsewhere on the board
unnamed: C26.2, R45.2, R46.1, R50.1
unnamed: C30.2, R53.2, R54.1, R55.1
unnamed: R44.1, U13.1 (RG)
unnamed: R44.2, U13.8 (RG)
unnamed: R47.1, R48.2
unnamed: C27.1, R46.2, U4.12 (+)
unnamed: C23.1, C24.2, R33.2, U13.3 (+IN)
unnamed: C22.1, C24.1, R27.2, U13.2 (-IN)
unnamed: C25.1, R51.1, R52.2, U13.5 (REF)
unnamed: R45.1, U13.6 (VOUT)
unnamed: R53.1, TP4.1 (1_1), U15.8, U15.10 (+)
unnamed: R48.1, R49.2, U15.9 (-)
unnamed: C31.1, R54.2, U15.13 (-)
unnamed: R57.2, R58.1, U16.4 (DIV)
unnamed: C31.2, R55.2, TP2.1 (1_1), U15.14, U16.1 (MOD)
unnamed: R59.2, TP3.1 (1_1), U16.6 (OUT)
unnamed: R56.2, U16.3 (SET)
unnamed: R59.1, U17.2 (A)

Notes on the sheet:
+75V Min, 108V Nom, +126V Max
0.52 Min, 0.877 Max Vmod = 0.00696*HV+
Connected per MCP6004 datasheet Fig 4-5
Voltage Sensing
Must be at least 0805 for voltage
Current Sensing
F_Out = 1MHz*50kR/(256*130kR) = 96kHz See LTC6992 P.15

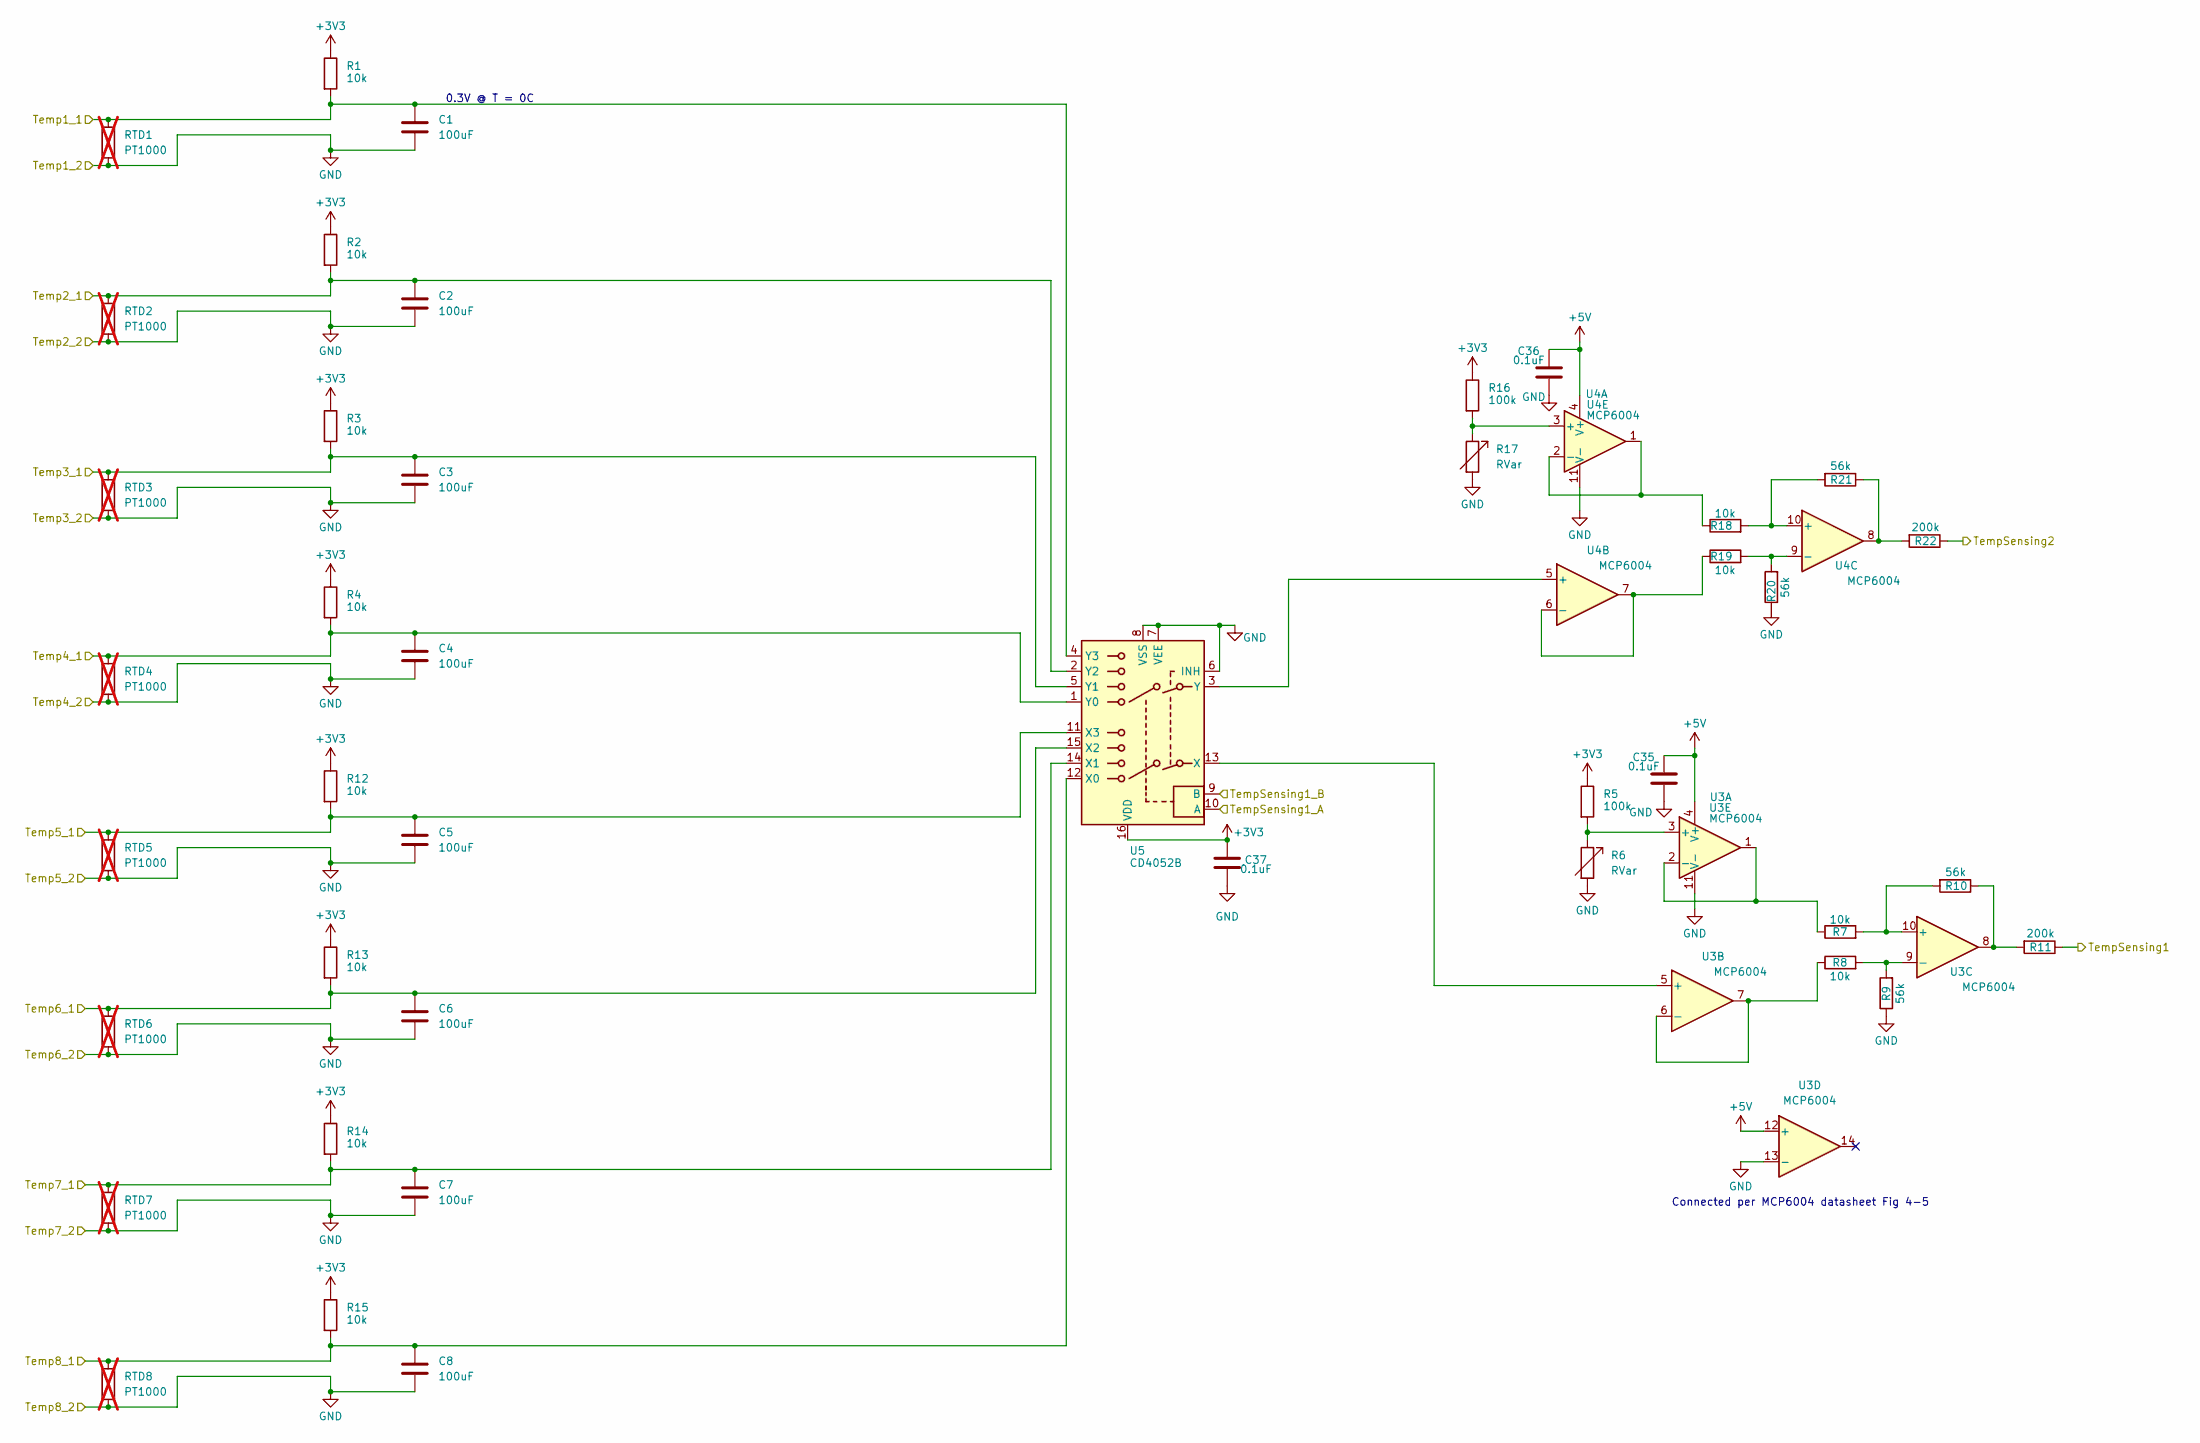
[picture p8: schematic temp_sense.kicad_sch, Discharger Main Board]

Parts:
C1, C2, C3, C4, C5, C6, C7, C8: 100uF; C_0805_2012Metric_Pad1.18x1.45mm_HandSolder
C35, C36, C37: 0.1uF; C_0805_2012Metric_Pad1.18x1.45mm_HandSolder
R1, R2, R3, R4, R7, R8, R12, R13, R14, R15, R18, R19: 10k; R_0805_2012Metric_Pad1.20x1.40mm_HandSolder
R5, R16: 100k; R_0805_2012Metric_Pad1.20x1.40mm_HandSolder
R6, R17: RVar; Potentiometer_Bourns_3296W_Vertical
R9, R10, R20, R21: 56k; R_0805_2012Metric_Pad1.20x1.40mm_HandSolder
R11, R22: 200k; R_0805_2012Metric_Pad1.20x1.40mm_HandSolder
RTD1, RTD2, RTD3, RTD4, RTD5, RTD6, RTD7, RTD8: PT1000; not fitted
U3, U4: MCP6004; SOIC-14_3.9x8.7mm_P1.27mm
U5: CD4052B; TSSOP-16_4.4x5mm_P0.65mm

Connections:
+3V3: C37.1, R1.1, R2.1, R3.1, R4.1, R5.1, R12.1, R13.1, R14.1, R15.1, R16.1, U5.16 (VDD); also elsewhere on the board
+5V: C35.1, C36.1, U3.4 (V+), U3.12 (+), U4.4 (V+); also elsewhere on the board
/Microcontroller/TempSensing1: R11.1; also elsewhere on the board
/Microcontroller/TempSensing1_A: U5.10 (A); also elsewhere on the board
/Microcontroller/TempSensing1_B: U5.9 (B); also elsewhere on the board
/Microcontroller/TempSensing2: R22.1; also elsewhere on the board
/Temperature Sensor Interface/Temp1_1: C1.1, R1.2, RTD1.1, U5.4 (Y3); also elsewhere on the board
/Temperature Sensor Interface/Temp2_1: C2.1, R2.2, RTD2.1, U5.2 (Y2); also elsewhere on the board
/Temperature Sensor Interface/Temp3_1: C3.1, R3.2, RTD3.1, U5.5 (Y1); also elsewhere on the board
/Temperature Sensor Interface/Temp4_1: C4.1, R4.2, RTD4.1, U5.1 (Y0); also elsewhere on the board
/Temperature Sensor Interface/Temp5_1: C5.1, R12.2, RTD5.1, U5.11 (X3); also elsewhere on the board
/Temperature Sensor Interface/Temp6_1: C6.1, R13.2, RTD6.1, U5.15 (X2); also elsewhere on the board
/Temperature Sensor Interface/Temp7_1: C7.1, R14.2, RTD7.1, U5.14 (X1); also elsewhere on the board
/Temperature Sensor Interface/Temp8_1: C8.1, R15.2, RTD8.1, U5.12 (X0); also elsewhere on the board
GND: C1.2, C2.2, C3.2, C4.2, C5.2, C6.2, C7.2, C8.2, C35.2, C36.2, C37.2, R6.2, R9.1, R17.2, R20.1, RTD1.2, RTD2.2, RTD3.2, RTD4.2, RTD5.2, RTD6.2, RTD7.2, RTD8.2, U3.11 (V-), U3.13 (-), U4.11 (V-), U5.6 (INH), U5.7 (VEE), U5.8 (VSS); also elsewhere on the board
unnamed: R10.1, R11.2, U3.8
unnamed: R21.1, R22.2, U4.8
unnamed: R5.2, R6.1, U3.3 (+)
unnamed: R7.1, U3.1, U3.2 (-)
unnamed: U3.5 (+), U5.13 (X)
unnamed: R8.1, U3.6 (-), U3.7
unnamed: R7.2, R10.2, U3.10 (+)
unnamed: R8.2, R9.2, U3.9 (-)
unnamed: R16.2, R17.1, U4.3 (+)
unnamed: R18.1, U4.1, U4.2 (-)
unnamed: U4.5 (+), U5.3 (Y)
unnamed: R19.1, U4.6 (-), U4.7
unnamed: R18.2, R21.2, U4.10 (+)
unnamed: R19.2, R20.2, U4.9 (-)

Notes on the sheet:
0.3V @ T = 0C
Connected per MCP6004 datasheet Fig 4-5

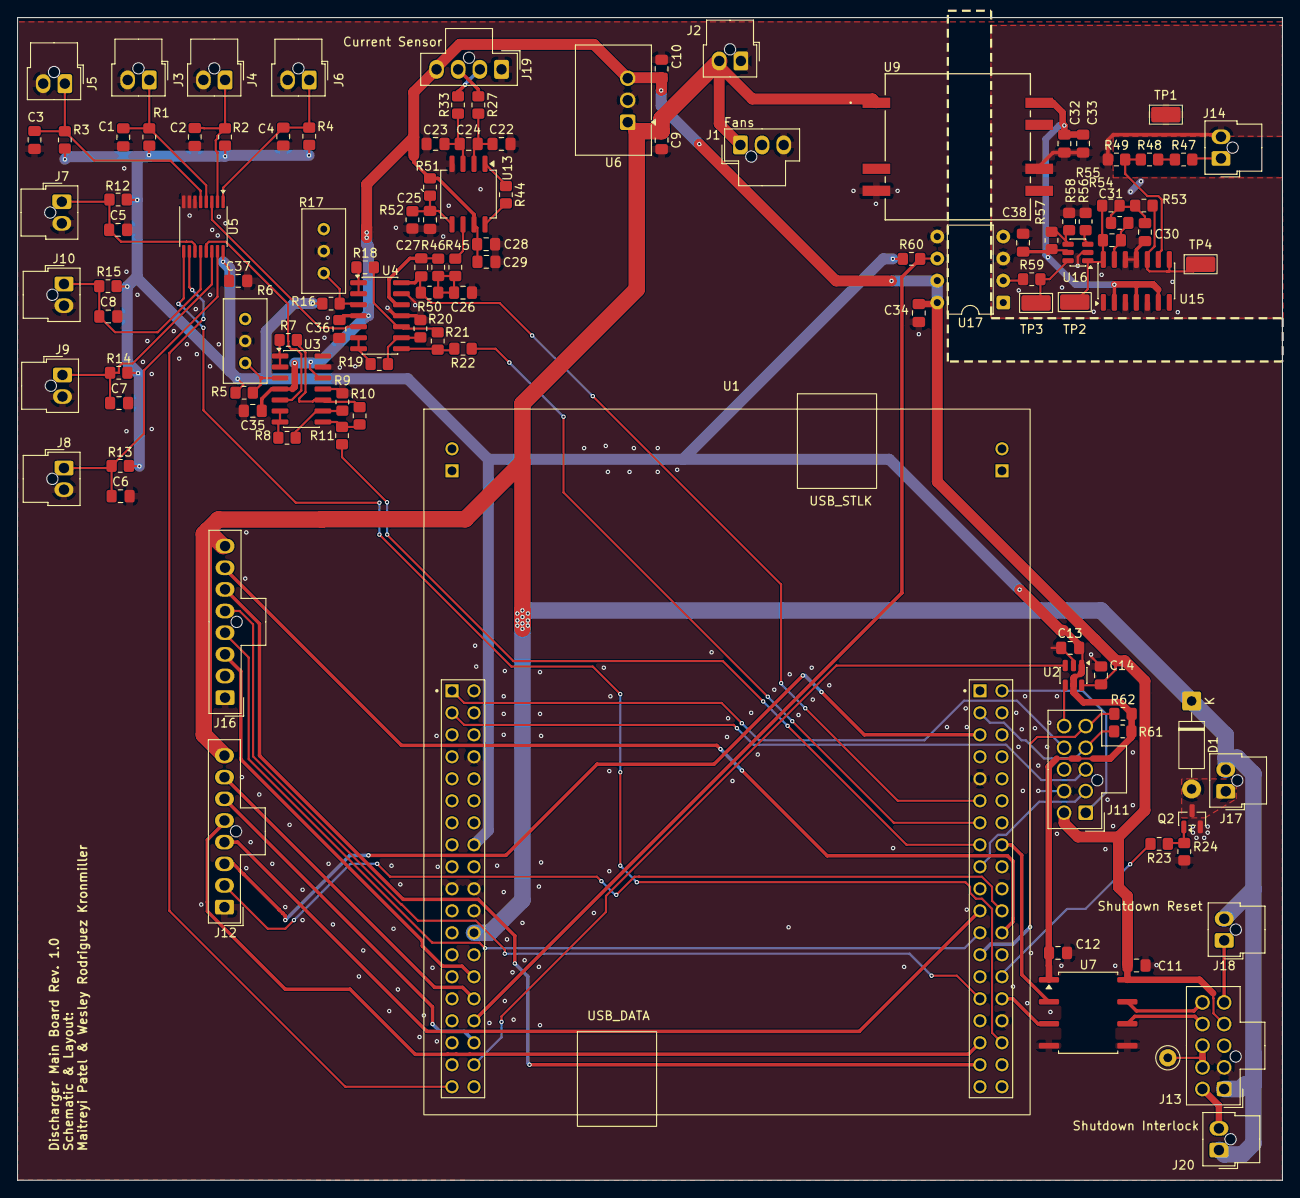
[picture p9: board ece129_discharger.kicad_pcb from above]

Board: 2 copper layers, 146.0 x 134.2 mm, 113 parts (0 on the bottom side), 84 nets.
