fezboy/ece129_discharger/hardware/gate_driver_daughter_board/gate_driver_daughter_board.kicad_pcb

## KiCad design hardware/gate_driver_daughter_board/gate_driver_daughter_board.kicad_pcb (2026-05-18)

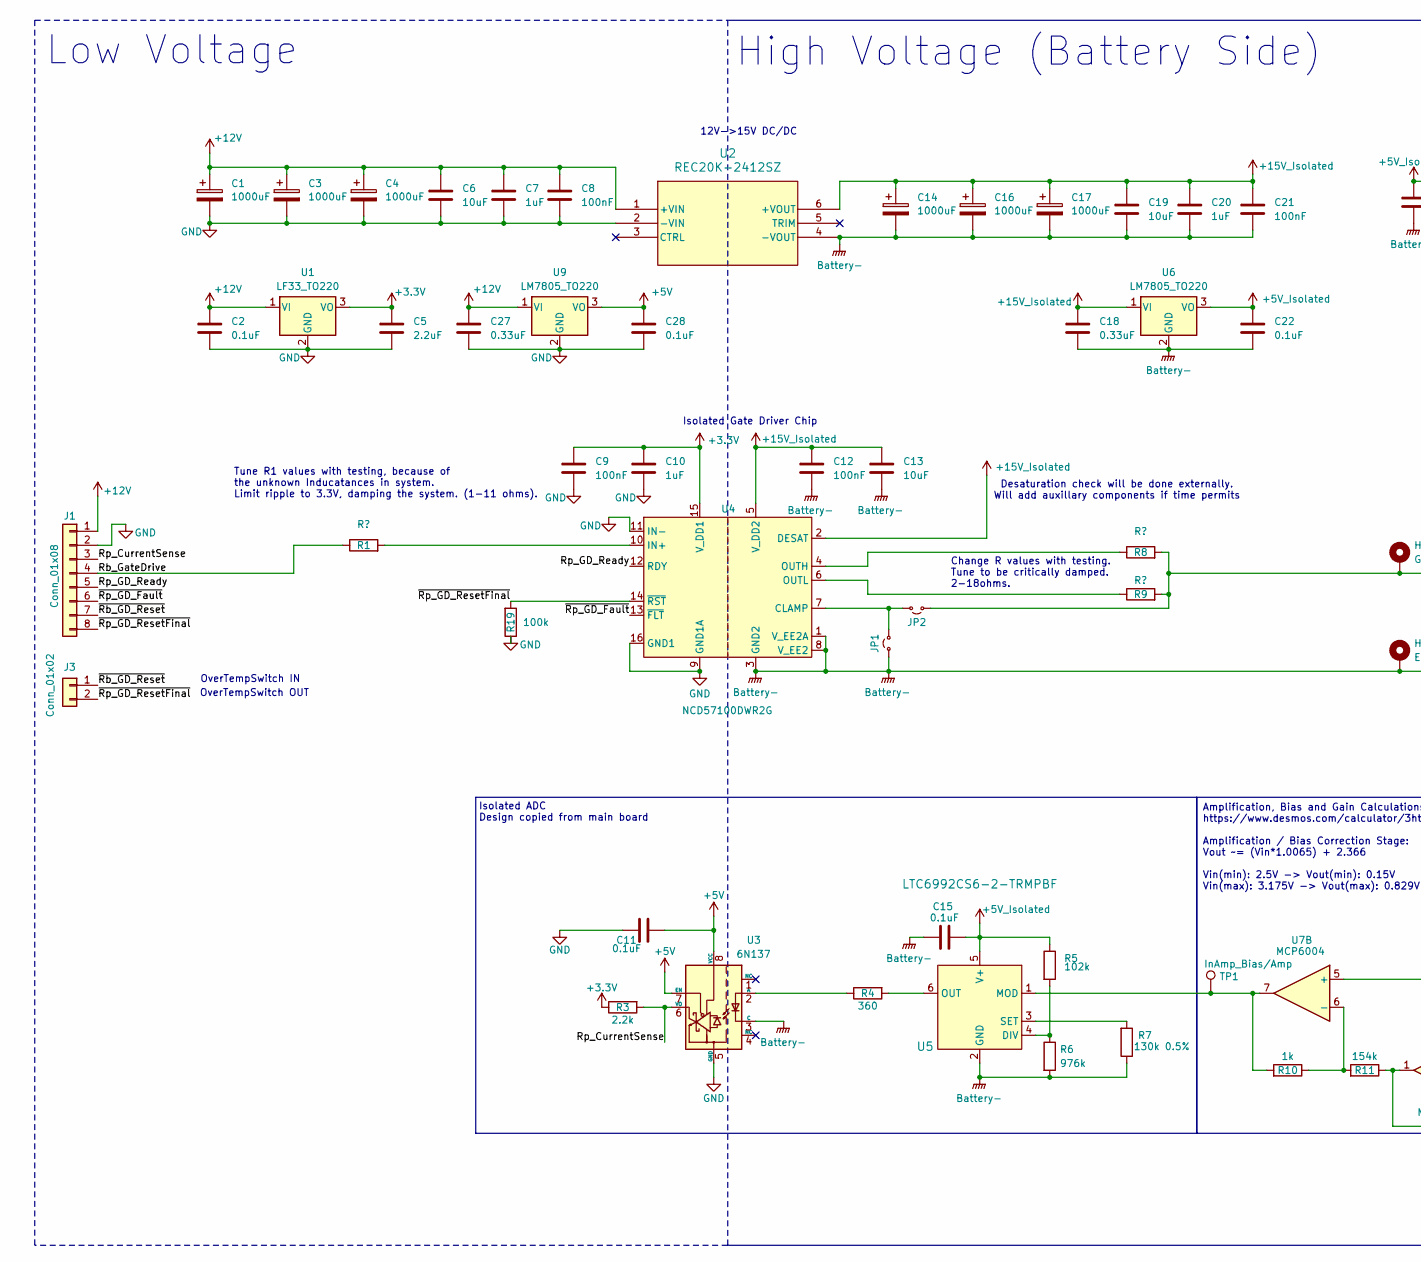
[picture p10: schematic gate_driver_daughter_board.kicad_sch, [BOARD NAME], part in row 1, column 1]

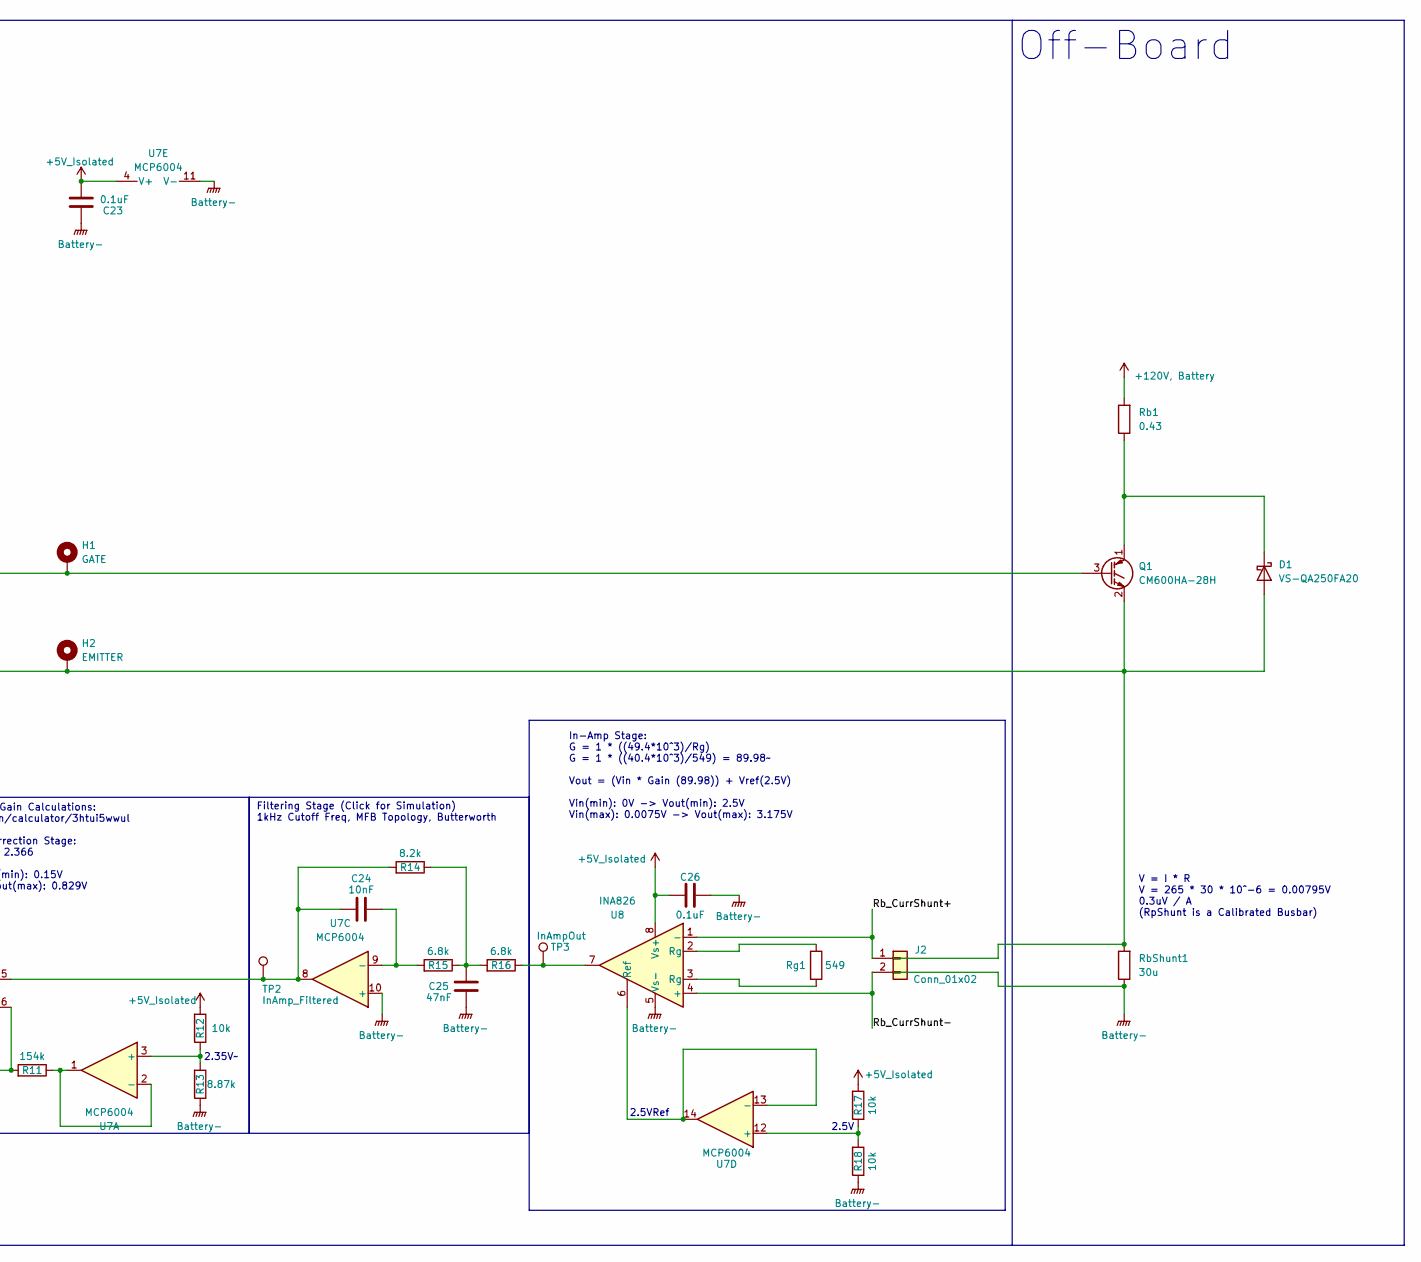
[picture p11: schematic gate_driver_daughter_board.kicad_sch, [BOARD NAME], part in row 1, column 2]

Parts:
C1, C3, C4, C14, C16, C17: 1000uF; 25V1000uF; Manufacturer Part Number Nichicon; Digikey Part Number UVY1E102MPD1TD
C2, C11, C15, C22, C23, C26, C28: 0.1uF; C_0805_2012Metric_Pad1.18x1.45mm_HandSolder
C5: 2.2uF; C_0805_2012Metric_Pad1.18x1.45mm_HandSolder
C6, C13, C19: 10uF; C_0805_2012Metric_Pad1.18x1.45mm_HandSolder
C7, C10, C20: 1uF; C_0805_2012Metric_Pad1.18x1.45mm_HandSolder
C8, C9, C12, C21: 100nF; C_0805_2012Metric_Pad1.18x1.45mm_HandSolder
C18, C27: 0.33uF; C_0805_2012Metric_Pad1.18x1.45mm_HandSolder
C24: 10nF; C_0805_2012Metric_Pad1.18x1.45mm_HandSolder
C25: 47nF; C_0805_2012Metric_Pad1.18x1.45mm_HandSolder
D1: VS-QA250FA20; Manufacturer Part Number Vishay Semiconductors; Digikey Part Number 78-VS-QA250FA20
H1: GATE; MountingHole_4.3x6.2mm_M4_Pad
H2: EMITTER; MountingHole_4.3x6.2mm_M4_Pad
J1: Conn_01x08; Molex_Nano-Fit_105309-xx08_1x08_P2.50mm_Vertical
J2, J3: Conn_01x02; Molex_Nano-Fit_105309-xx02_1x02_P2.50mm_Vertical
JP1, JP2: Jumper_2_Small_Open; PinHeader_1x02_P2.54mm_Vertical
Q1: CM600HA-28H
R1, R8, R9: R?; R_1206_3216Metric_Pad1.30x1.75mm_HandSolder
R3: 2.2k; R_0805_2012Metric_Pad1.20x1.40mm_HandSolder
R4: 360; R_0805_2012Metric_Pad1.20x1.40mm_HandSolder
R5: 102k; R_0805_2012Metric_Pad1.20x1.40mm_HandSolder
R6: 976k; R_0805_2012Metric_Pad1.20x1.40mm_HandSolder
R7: 130k 0.5%; R_0805_2012Metric_Pad1.20x1.40mm_HandSolder
R10: 1k; R_0805_2012Metric_Pad1.20x1.40mm_HandSolder
R11: 154k; R_0805_2012Metric_Pad1.20x1.40mm_HandSolder
R12, R17, R18: 10k; R_0805_2012Metric_Pad1.20x1.40mm_HandSolder
R13: 8.87k; R_0805_2012Metric_Pad1.20x1.40mm_HandSolder
R14: 8.2k; R_0805_2012Metric_Pad1.20x1.40mm_HandSolder
R15, R16: 6.8k; R_0805_2012Metric_Pad1.20x1.40mm_HandSolder
R19: 100k; R_0805_2012Metric_Pad1.20x1.40mm_HandSolder
Rb1: 0.43
RbShunt1: 30u
Rg1: 549; R_0805_2012Metric_Pad1.20x1.40mm_HandSolder
TP1: InAmp_Bias/Amp; TestPoint_Pad_D3.0mm
TP2: InAmp_Filtered; TestPoint_Pad_D3.0mm
TP3: InAmpOut; TestPoint_Pad_2.0x2.0mm
U1: LF33_TO220; TO-220-3_Vertical
U2: REC20K-2412SZ; REC20K_RCP
U3: 6N137; DIP-8_W7.62mm
U4: NCD57100DWR2G; SOIC-16W_7.5x10.3mm_P1.27mm; MFG PN NCD57100DWR2G; Digi PN 488-NCD57100DWR2GTR-ND
U5: LTC6992CS6-2-TRMPBF; TSOT-23-6; MFG PN LTC6992CS6-2-TRMPBF; Digi PN 505-LTC6992CS6-2#TRMPBFCT-ND
U6, U9: LM7805_TO220; TO-220-3_Vertical
U7: MCP6004; SOIC-14_3.9x8.7mm_P1.27mm
U8: INA826; SOIC-8_3.9x4.9mm_P1.27mm

Connections:
+3.3V: C5.2, C9.2, C10.2, R3.1, U1.3 (VO), U4.15 (V_DD1)
+5V: C11.1, C28.2, U3.7 (EN), U3.8 (VCC), U9.3 (VO)
+5V_Isolated: C15.1, C22.2, C23.2, C26.2, R5.1, R12.2, R17.2, U5.5 (V+), U6.3 (VO), U7.4 (V+), U8.8 (Vs+)
+12V: C1.1, C2.2, C3.1, C4.1, C6.2, C7.2, C8.2, C27.2, J1.1, U1.1 (VI), U2.1 (+VIN), U9.1 (VI)
+15V_Isolated: C12.2, C13.2, C14.1, C16.1, C17.1, C18.2, C19.2, C20.2, C21.2, U2.6 (+VOUT), U4.2 (DESAT), U4.5 (V_DD2), U6.1 (VI)
/Rb_CurrShunt+: J2.1, U8.1 (-)
/Rb_CurrShunt-: J2.2, U8.4 (+)
/Rb_GateDrive: J1.4, R1.1
/Rp_CurrentSense: J1.3, R3.2, U3.6 (VO)
/Rp_GD_Ready: J1.5, U4.12 (RDY)
/~Rb_GD_Reset: J1.7, J3.1
/~Rp_GD_Fault: J1.6, U4.13 (~FLT)
/~Rp_GD_ResetFinal: J1.8, J3.2, R19.2, U4.14 (~RST)
Battery-: C12.1, C13.1, C14.2, C15.2, C16.2, C17.2, C18.1, C19.1, C20.1, C21.1, C22.1, C23.1, C25.1, C26.1, D1.2 (A), H2.MP (MP_MP), JP1.1 (A), Q1.2 (E), R6.2, R7.1, R13.1, R18.1, RbShunt1.1, RbShunt1.2, U2.4 (-VOUT), U3.3 (C), U4.1 (V_EE2A), U4.3 (GND2), U4.8 (V_EE2), U5.2 (GND), U6.2 (GND), U7.10 (+), U7.11 (V-), U8.5 (Vs-)
GND: C1.2, C2.1, C3.2, C4.2, C5.1, C6.1, C7.1, C8.1, C9.1, C10.1, C11.2, C27.1, C28.1, J1.2, R19.1, U1.2 (GND), U2.2 (-VIN), U3.5 (GND), U4.9 (GND1A), U4.11 (IN-), U4.16 (GND1), U9.2 (GND)
unnamed: C25.2, R14.1, R15.1, R16.2
unnamed: D1.1 (K), Q1.1 (C), Rb1.1
unnamed: JP1.2 (B), JP2.2 (B), U4.7 (CLAMP)
unnamed: H1.MP (MP_MP), JP2.1 (A), Q1.3 (G), R8.2, R9.2
unnamed: R16.1, TP3.1 (1_1), U8.7
unnamed: Rg1.1, U8.2 (Rg)
unnamed: Rg1.2, U8.3 (Rg)
unnamed: R4.1, U3.2 (A)
unnamed: R1.2, U4.10 (IN+)
unnamed: R8.1, U4.4 (OUTH)
unnamed: R9.1, U4.6 (OUTL)
unnamed: R5.2, R6.1, U5.4 (DIV)
unnamed: R10.2, TP1.1 (1_1), U5.1 (MOD), U7.7
unnamed: R4.2, U5.6 (OUT)
unnamed: R7.2, U5.3 (SET)
unnamed: R12.1, R13.2, U7.3 (+)
unnamed: R11.1, U7.1, U7.2 (-)
unnamed: C24.1, R14.2, TP2.1 (1_1), U7.5 (+), U7.8
unnamed: R10.1, R11.2, U7.6 (-)
unnamed: C24.2, R15.2, U7.9 (-)
unnamed: R17.1, R18.2, U7.12 (+)
unnamed: U7.13 (-), U7.14, U8.6 (Ref)

Notes on the sheet:
Isolated Gate Driver Chip
Amplification, Bias and Gain Calculations: https://www.desmos.com/calculator/3htui5wwul Amplification / Bias Correction Stage: Vout ~= (Vin*1.0065) + 2.366 Vin(min): 2.5V -> Vout(min): 0.15V Vin(max): 3.175V -> Vout(max): 0.829V
2.35V~
12V->15V DC/DC
In-Amp Stage: G = 1 * ((49.4*10^3)/Rg) G = 1 * ((40.4*10^3)/549) = 89.98~ Vout = (Vin * Gain (89.98)) + Vref(2.5V) Vin(min): 0V -> Vout(min): 2.5V Vin(max): 0.0075V -> Vout(max): 3.175V
Low Voltage
Desaturation check will be done externally. Will add auxillary components if time permits
Isolated ADC Design copied from main board
2.5VRef
OverTempSwitch OUT
2.5V
V = I * R V = 265 * 30 * 10^-6 = 0.00795V 0.3uV / A (RpShunt is a Calibrated Busbar)
Tune R1 values with testing, because of the unknown Inducatances in system. Limit ripple to 3.3V, damping the system. (1-11 ohms).
OverTempSwitch IN
Off-Board
High Voltage (Battery Side)
Change R values with testing. Tune to be critically damped. 2-18ohms.
Filtering Stage (Click for Simulation) 1kHz Cutoff Freq, MFB Topology, Butterworth

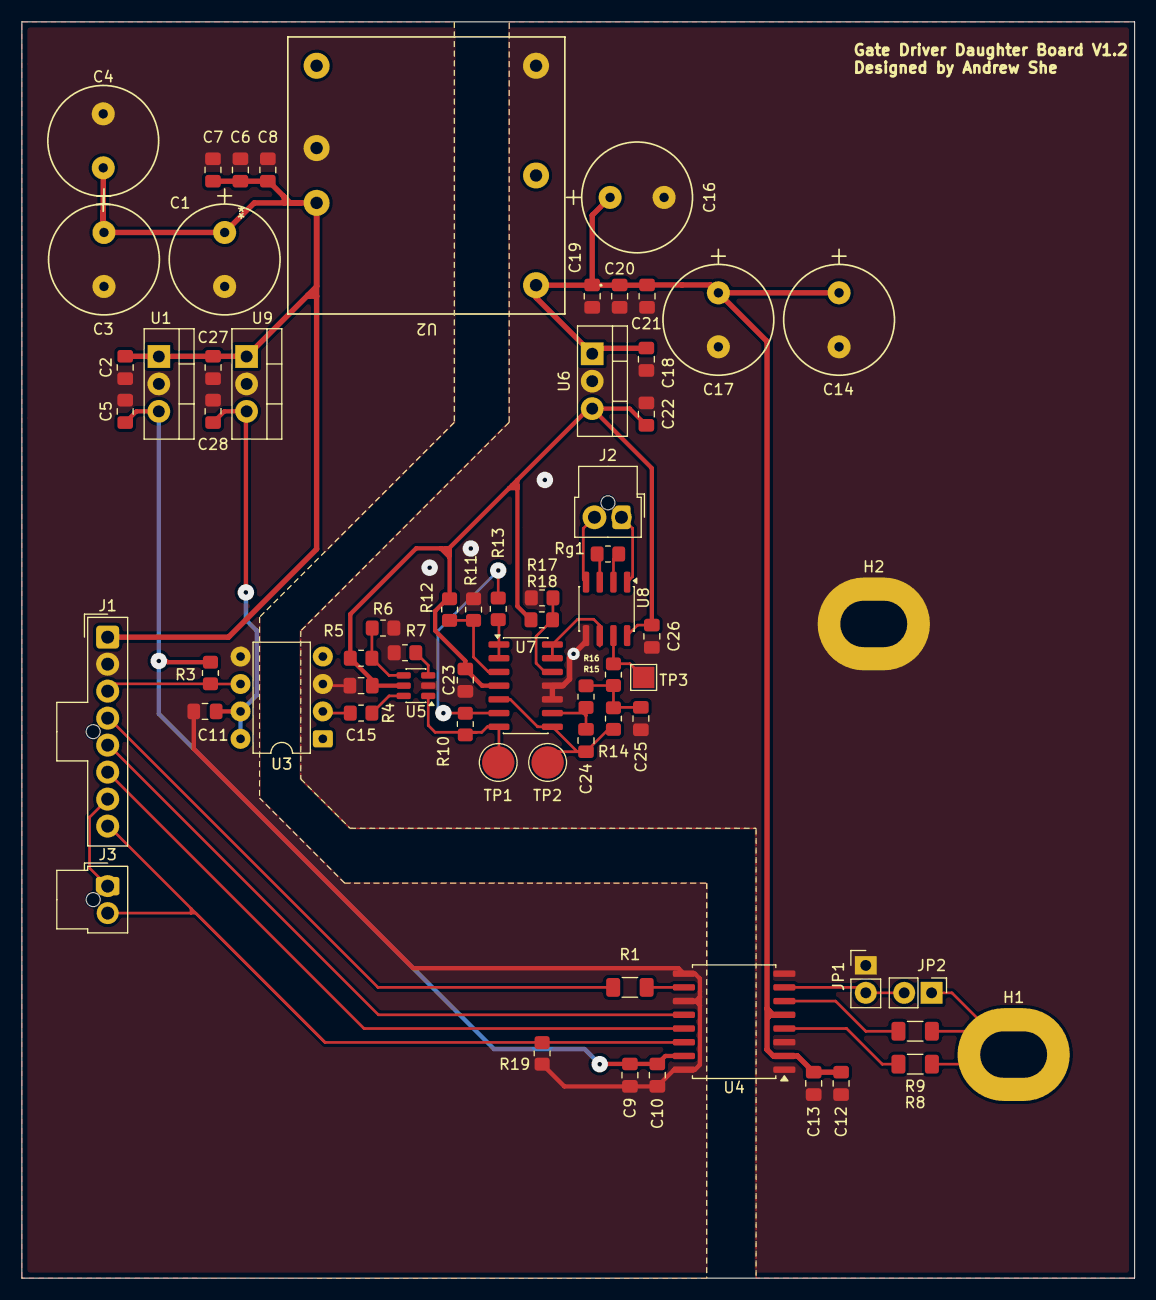
[picture p12: board gate_driver_daughter_board.kicad_pcb from above]

Board: 2 copper layers, 103.0 x 116.3 mm, 66 parts (0 on the bottom side), 36 nets.
