fezboy/ece129_discharger/(commit log)

2026-04-08 Add Gate Driver Daughter Board subproject
    [gate_driver_daughter_board.kicad_pcb, gate_driver_daughter_board.kicad_sch]
2026-04-08 Add main board subpages
    [ece129_discharger.kicad_sch, mcu.kicad_sch, temp_sense.kicad_sch, voltage_current_sense.kicad_sch]
2026-04-23 Added NCD57100DWR2G Gate Driver Symbol (Daughter Board Library)
    [gate_driver_daughter_board.kicad_sch]
2026-04-23 MBR0.0.1 - Begin addition of sheet pins to MCU page
    Incomplete
    [ece129_discharger.kicad_sch, mcu.kicad_sch, temp_sense.kicad_sch, voltage_current_sense.kicad_sch]
2026-04-27 temperature sensing initial
    [temp_sense.kicad_sch]
2026-04-28 sensing schematics
    [temp_sense.kicad_sch, voltage_current_sense.kicad_sch]
2026-05-01 R0.0.2 Add more connections to MCU, some connectors
    commit d1f92fde9a9b01f608e388bb27e003f4547c4ba5
    Author: fezboy <31973884+fezboy@users.noreply.github.com>
    Date: Tue Apr 28 12:29:51 2026 -0700
    R0.0.2 Add more connections to MCU, some connectors
    [ece129_discharger.kicad_sch, mcu.kicad_sch]
2026-05-01 pushing all changes
    [voltage_current_sense.kicad_sch]
2026-05-02 R0.0.3 Correct Voltage measurement frequency and divider
    [ece129_discharger.kicad_sch, mcu.kicad_sch, temp_sense.kicad_sch, voltage_current_sense.kicad_sch]
2026-05-04 DC/DC added, incomplete Current sense, and incomplete snubber circuit
    [gate_driver_daughter_board.kicad_sch]
2026-05-06 Pre-Testing Changes (Used for Presentation Graphics)
    [gate_driver_daughter_board.kicad_sch]
2026-05-08 Start work on MCU Connections
    [mcu.kicad_sch]
2026-05-08 new sensor changes, need to still add low pass for voltage
    [temp_sense.kicad_sch, voltage_current_sense.kicad_sch]
2026-05-10 adding connectors
    [ece129_discharger.kicad_sch, temp_sense.kicad_sch, voltage_current_sense.kicad_sch]
2026-05-12 DC/DC Change
    [gate_driver_daughter_board.kicad_sch]
2026-05-12 chebyshev filter for voltage sense 2.0
    [mcu.kicad_sch, voltage_current_sense.kicad_sch]
2026-05-13 Pin assignment first draft
    [ece129_discharger.kicad_sch, mcu.kicad_sch, temp_sense.kicad_sch, voltage_current_sense.kicad_sch]
2026-05-13 Filter Stage Added, Current Gain Stage Added, Simulation Added
    [gate_driver_daughter_board.kicad_sch]
2026-05-13 Final Schematic Changes, Footprints assigned, ready for review / layout
    [gate_driver_daughter_board.kicad_pcb, gate_driver_daughter_board.kicad_sch]
2026-05-13 changes to sensing and footprints added
    [ece129_discharger.kicad_sch, temp_sense.kicad_sch, voltage_current_sense.kicad_sch]
2026-05-14 Add Isolation Keepout Zone, little bit of ground routing
    [gate_driver_daughter_board.kicad_pcb]
2026-05-14 Annular Ring Adjustment
    [gate_driver_daughter_board.kicad_pcb]
2026-05-15 V1.0 PCB Ready to Mill, Gate Driver Daughter Board
    [gate_driver_daughter_board.kicad_pcb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]
2026-05-15 V1.1, M60 Milling Accomodations
    [gate_driver_daughter_board.kicad_pcb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]
2026-05-15 V1.2, JLC Order PCB Updates
    [gate_driver_daughter_board.kicad_pcb]
2026-05-18 completed main board schematic
    [ece129_discharger.kicad_sch, mcu.kicad_sch, temp_sense.kicad_sch, voltage_current_sense.kicad_sch]
2026-05-20 changes to battery connector
    [ece129_discharger.kicad_sch, temp_sense.kicad_sch, voltage_current_sense.kicad_sch]
2026-05-22 initial layout, power traces remain
    [ece129_discharger.kicad_pcb, ece129_discharger.kicad_sch, mcu.kicad_sch, temp_sense.kicad_sch, voltage_current_sense.kicad_sch]
2026-05-23 Finished Layout and routing
    * Flipped CAN transceiver upside down on schematic
    * Moved CAN transceiver nearer to J13 and MCU CAN pins
    * Moved 5V DCDC caps nearer to 5V DCDC
    * Moved Silkscreen out from under U9
    * Moved J2 and J1 to prevent plugging 12V into a temp sensor connector
    * Change +3.3V to +3V3 to match MCU page
    * Changed Current Sense circuit to use U4D, sharing with Temp Sense (for easier assembly)
    * Placed Unused MCP6004s on schematic and connected them per datasheet fig 4-5
    * Remove connections to HV- in Current Sensing (Replaced with GND)
    * Tightened up Temp and Current Sense amplifier layouts
    * Swap U15A with U15D for easier routing
    * Added buffer to voltage sense circuit becau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
    [ece129_discharger.kicad_pcb, ece129_discharger.kicad_sch, mcu.kicad_sch, temp_sense.kicad_sch, voltage_current_sense.kicad_sch]
2026-05-23 Fix up silkscreen, testpoints, and one more decoupler
    [ece129_discharger.kicad_pcb, temp_sense.kicad_sch, voltage_current_sense.kicad_sch]
2026-05-23 final rev 1.0 complete
    [ece129_discharger.kicad_pcb]
